agkaminski/ZAK180/3dprint/bottom.stl

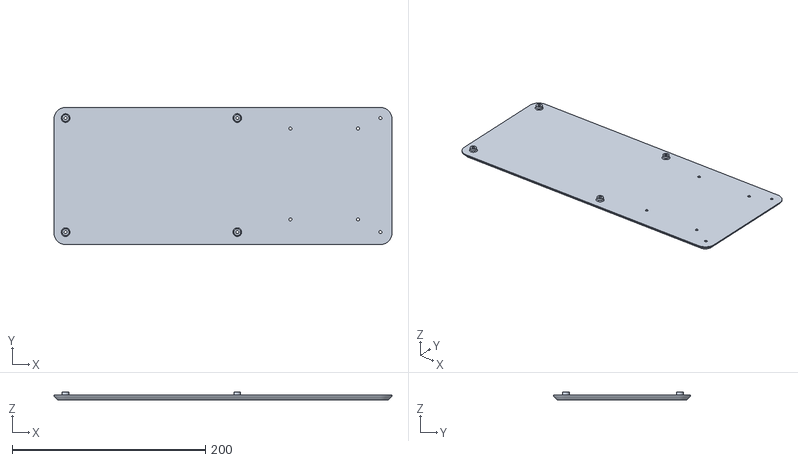
[picture p1: CAD file, 2025-01-13]
3dprint/bottom.stl
350.0 x 142.0 x 8.40
