agkaminski/ZAK180/extras/ESP8266/case.stl

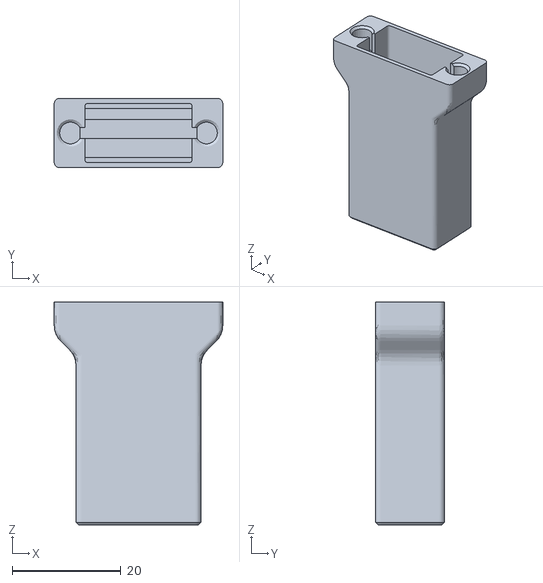
[picture p2: CAD file, 2024-10-10]
extras/ESP8266/case.stl
31.0 x 12.8 x 41.0
