agkaminski/ZAK180/3dprint/case.FCStd

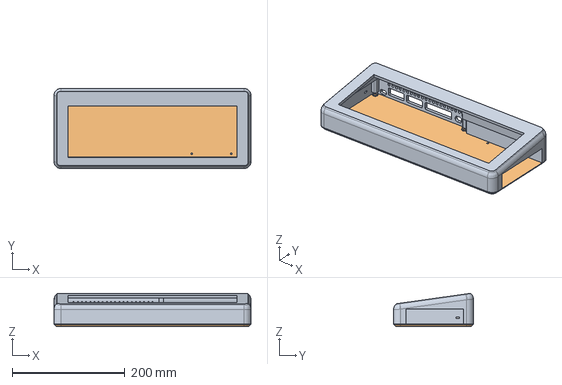
[picture p3: CAD file, 2025-01-13]
3dprint/case.FCStd
350.0 x 142.0 x 59.3 mm
case
bottom
