agkaminski/ZAK180/3dprint/dev.FCStd

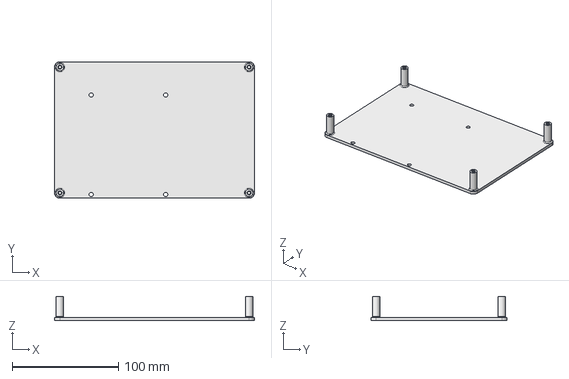
[picture p4: CAD file, 2024-09-09]
3dprint/dev.FCStd
188.0 x 128.3 x 23.0 mm
