agkaminski/ZAK180/(list of files, cad)

Other CAD files:
3dprint/case.stl
3dprint/dev.stl
