agkaminski/ZAK180/schematic.pdf

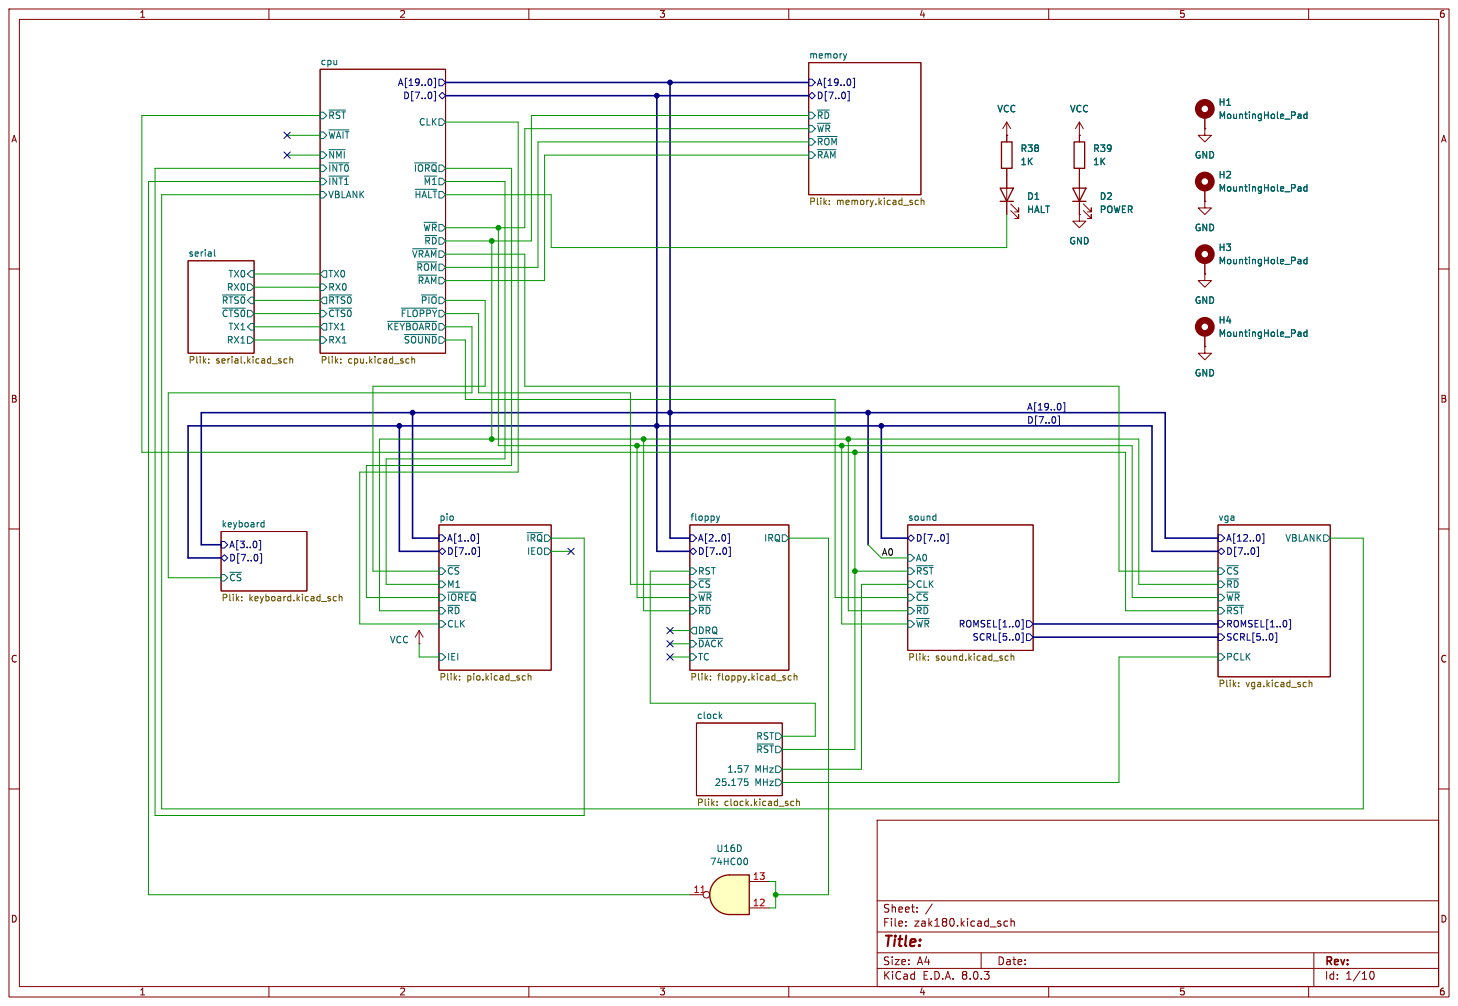
[picture p5: page 1]

Id: 1/10 Title: File: zak180.kicad_sch Sheet: /

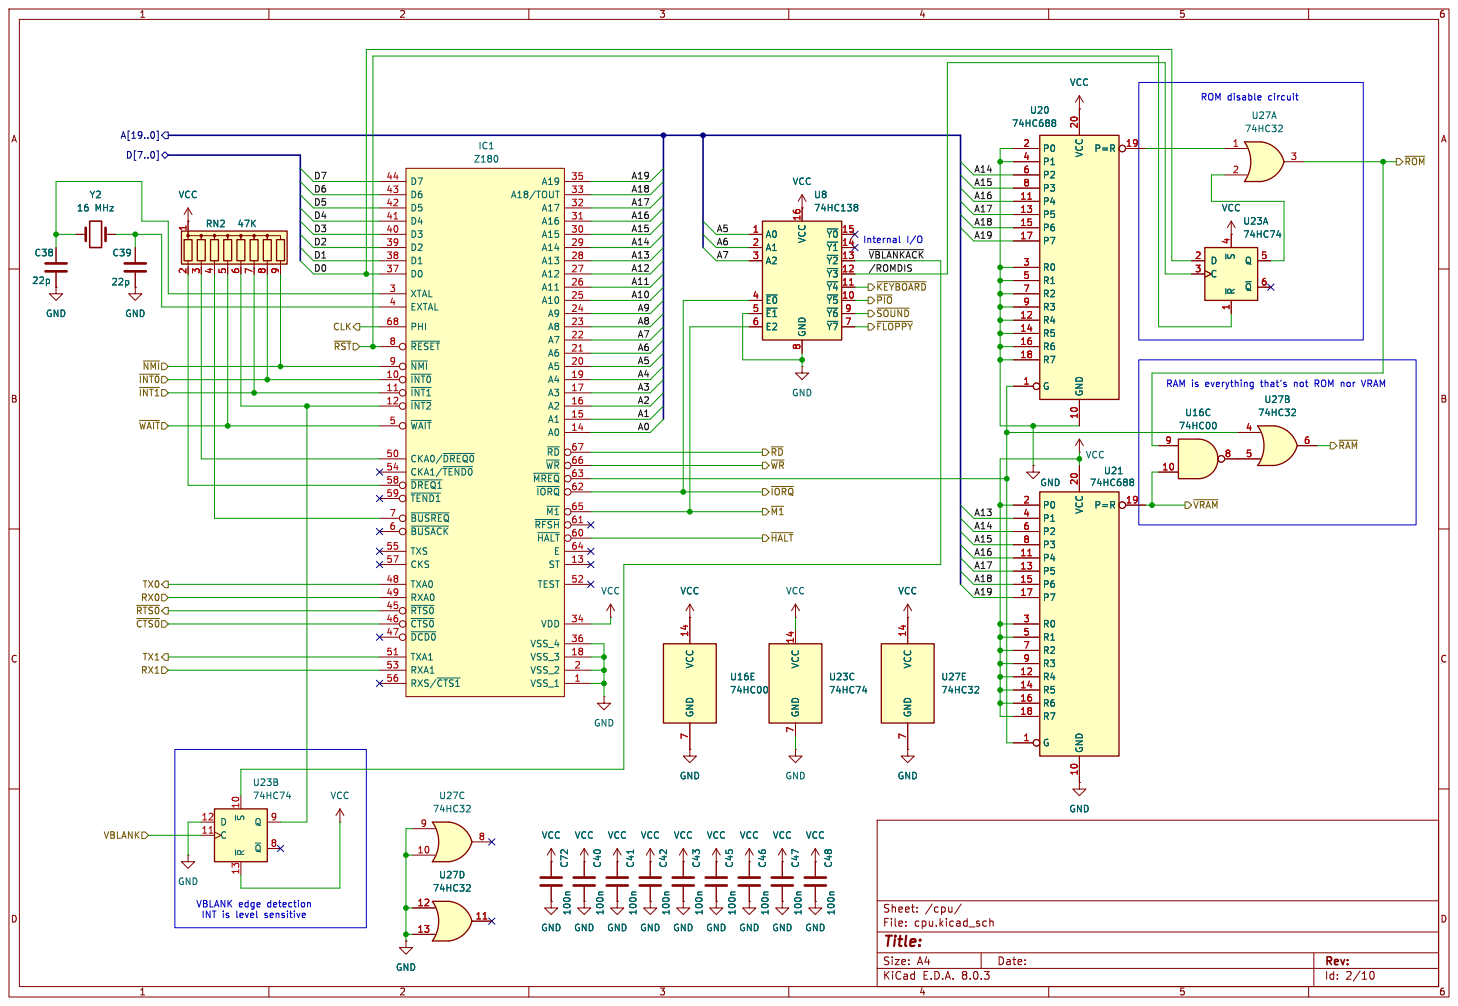
[picture p6: page 2]

ROM disable circuit VCC

VBLANK edge detection
INT is level sensitive

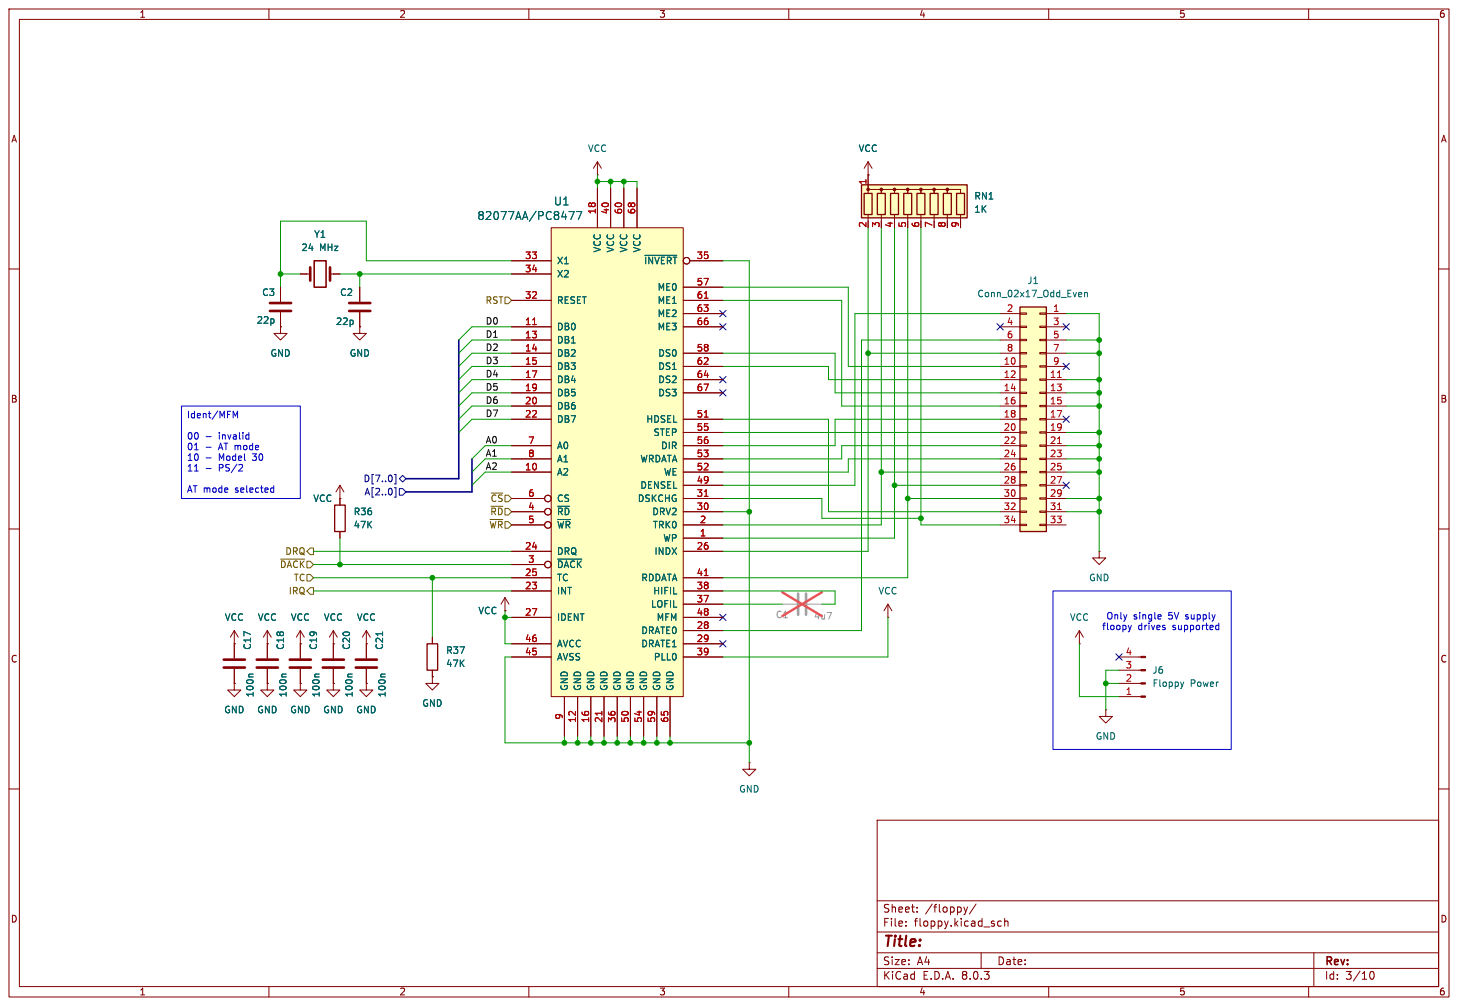
[picture p7: page 3]

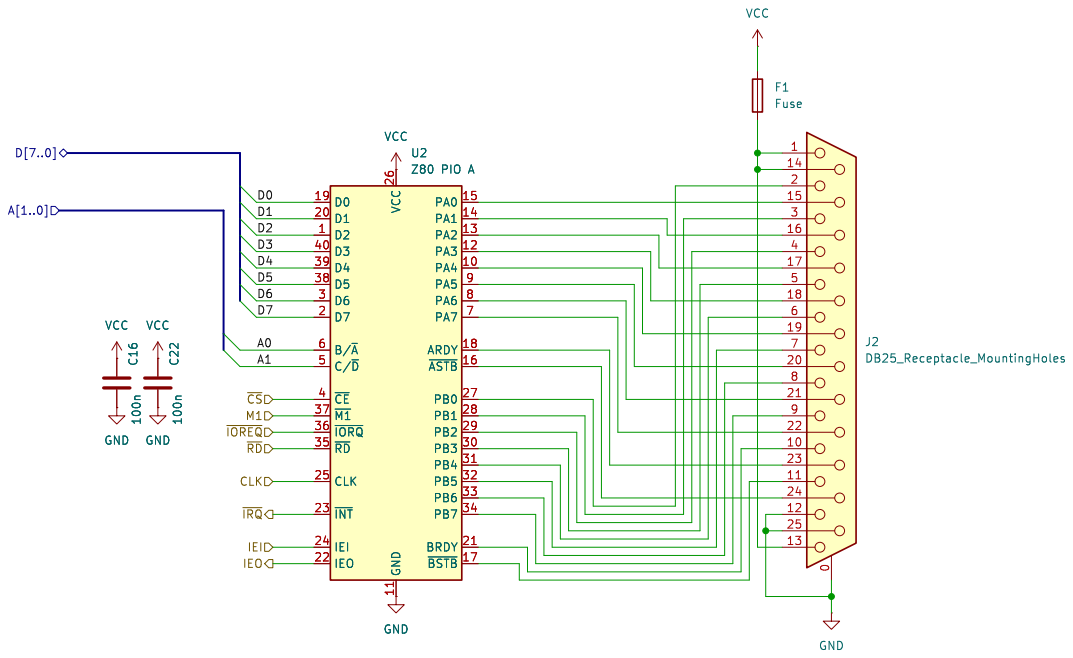
[picture p8: page 4]

Id: 5/10 Title: File: pio.kicad_sch Sheet: /pio/

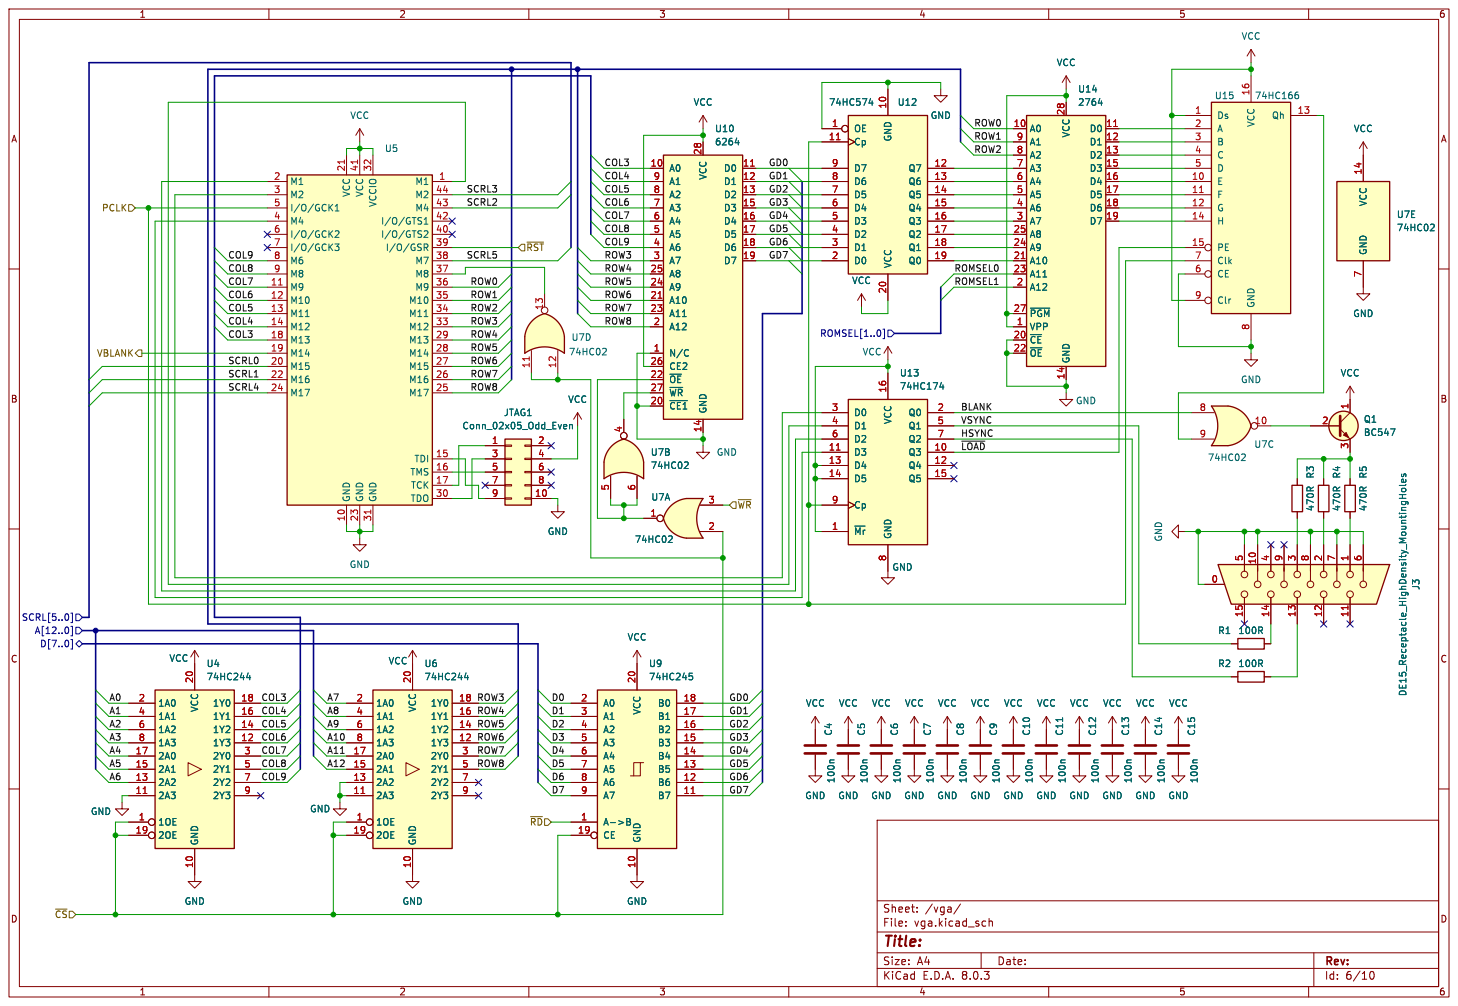
[picture p9: page 5]

3 Q1 BC547 VCC VCC GND GND GND C12 100n VCC

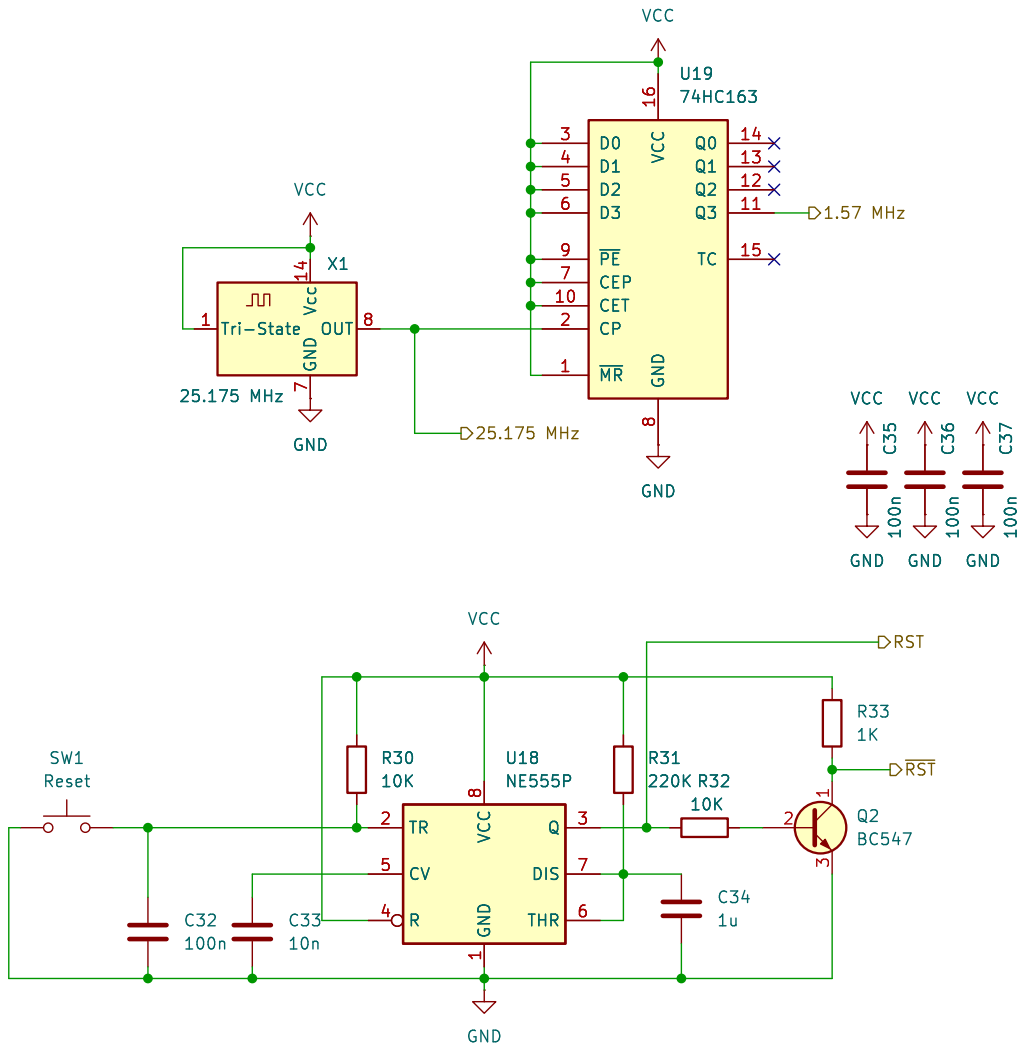
[picture p10: page 6]

Id: 7/10 Title: File: clock.kicad_sch Sheet: /clock/ C34

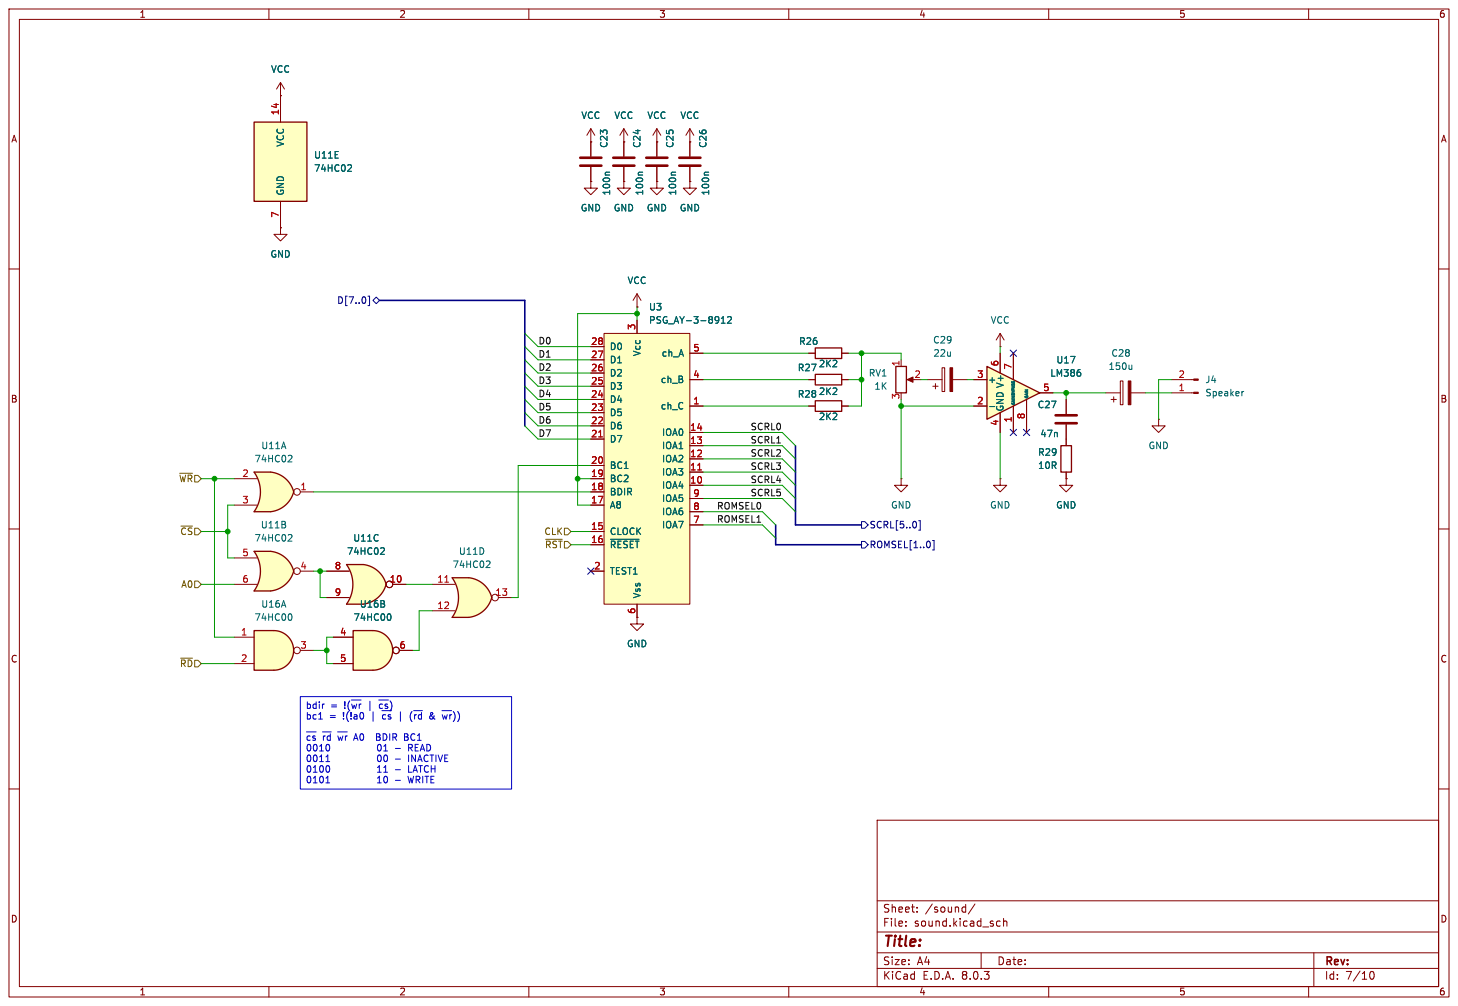
[picture p11: page 7]

bdir = !(~{wr}| ~{cs}) bc1 = !(!a0 | ~{cs}| (~{rd}& ~{wr}))

~{cs}~{rd}~{wr}A0 BDIR BC1

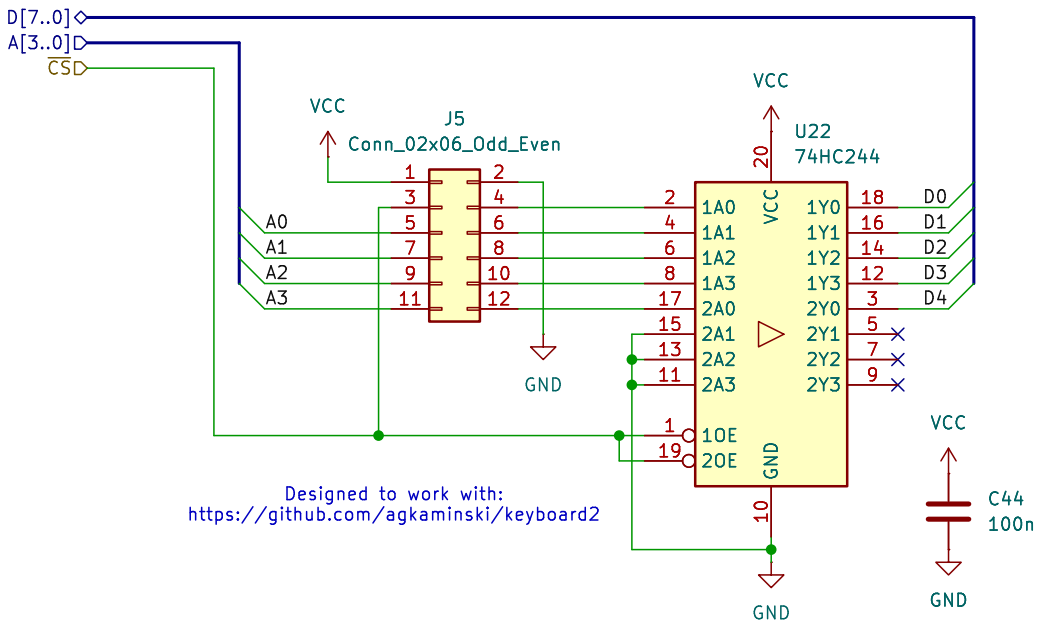
[picture p12: page 8]

Id: 8/10 Title: File: keyboard.kicad_sch Sheet: /keyboard/ VCC

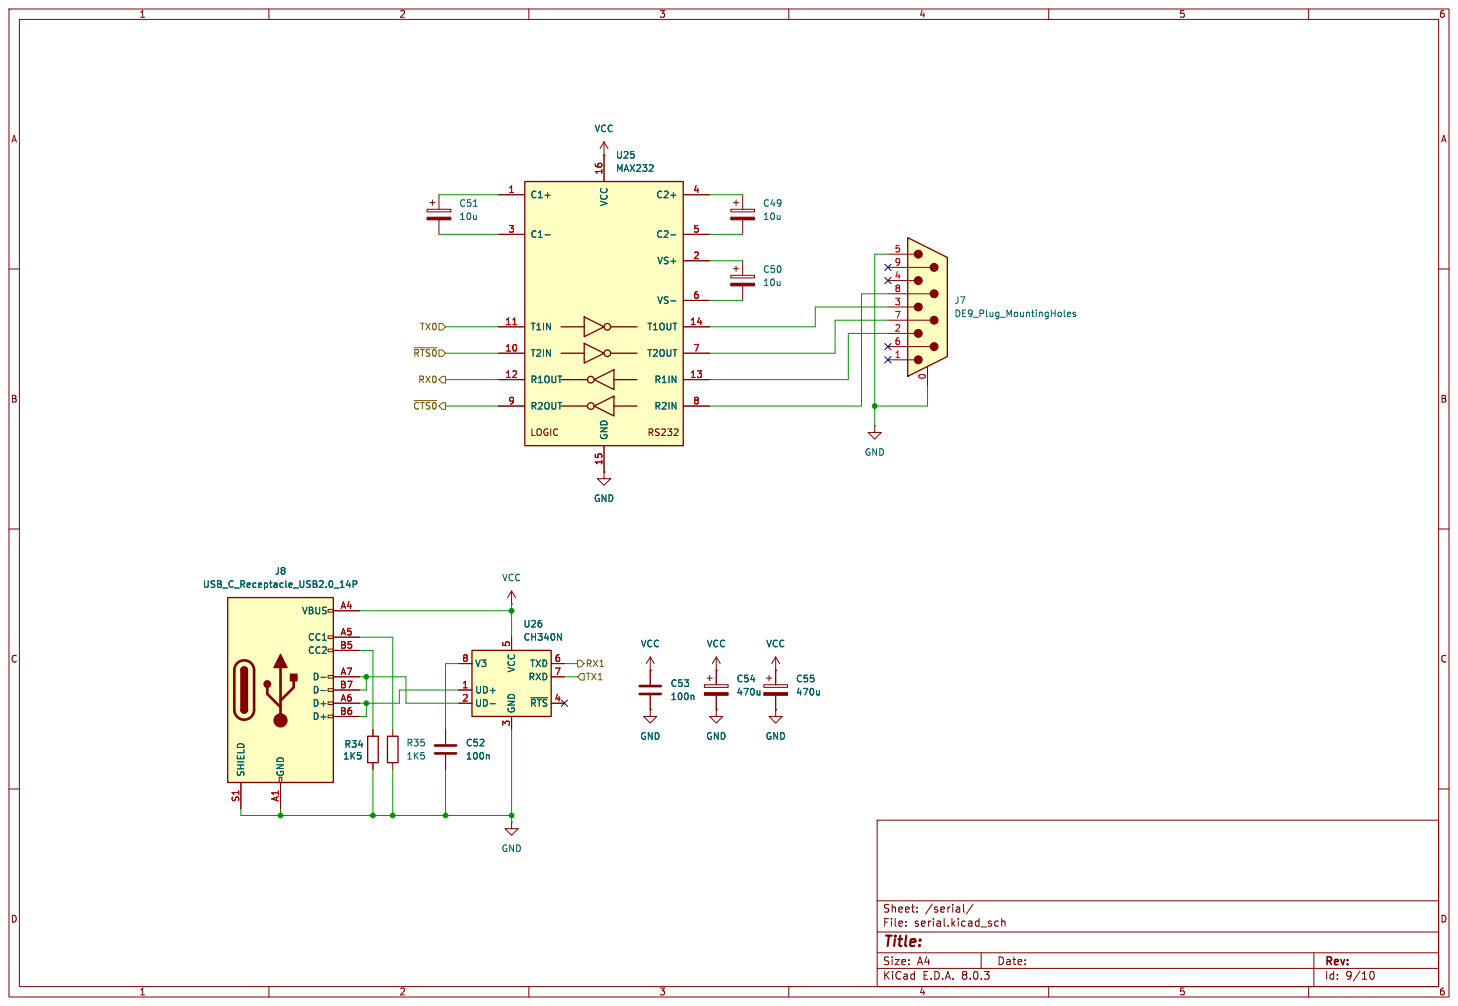
[picture p13: page 9]

Id: 9/10 Title: File: serial.kicad_sch Sheet: /serial/ C52

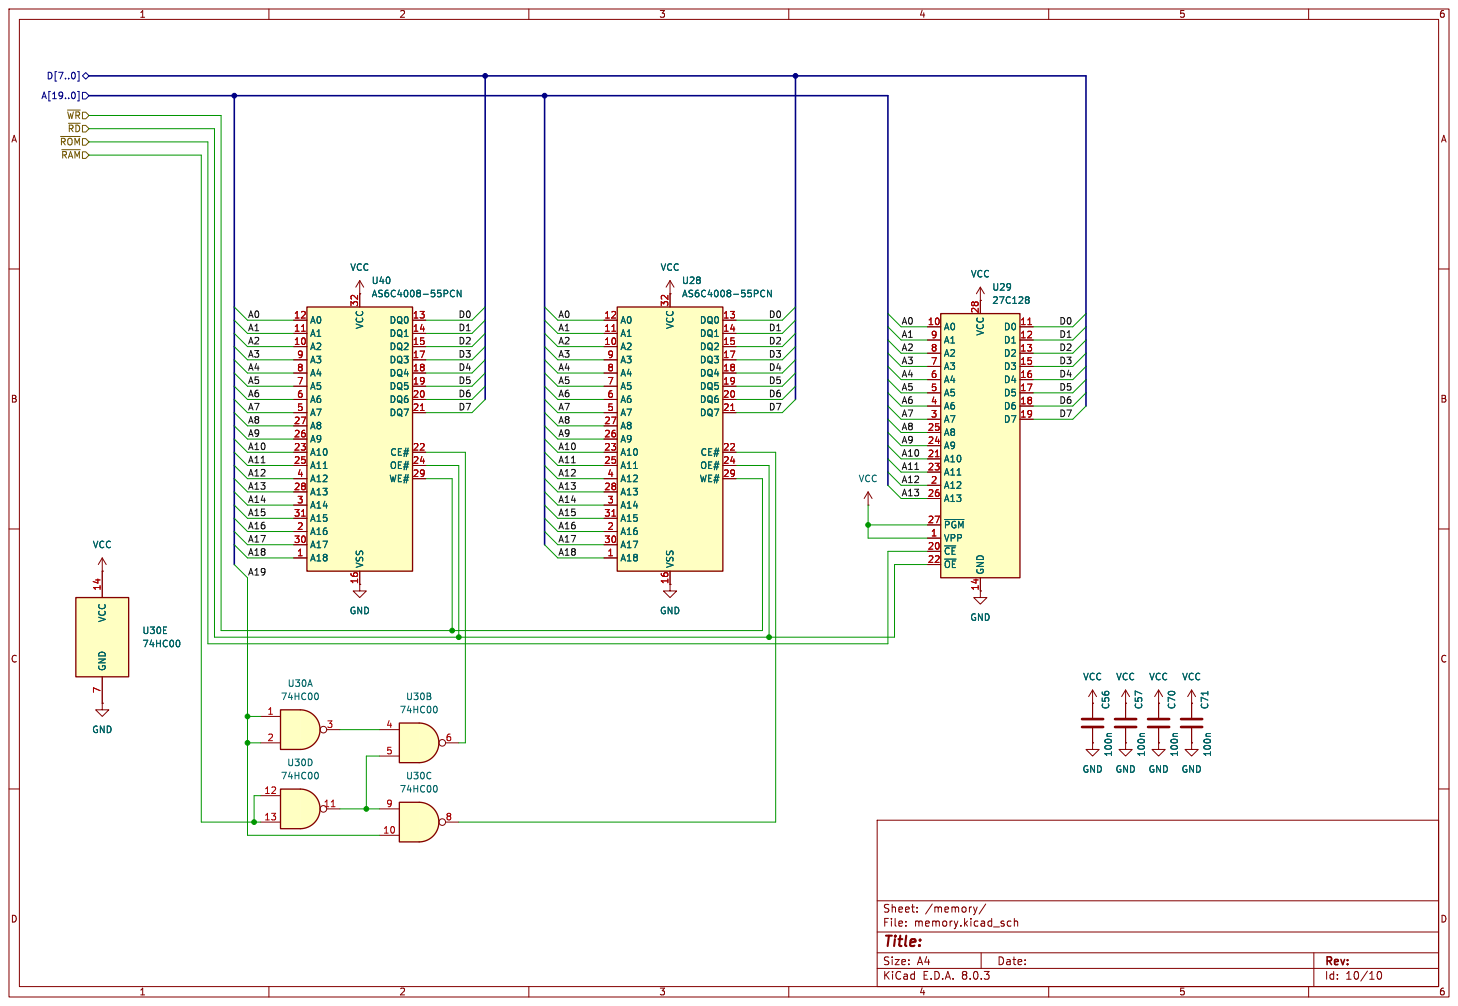
[picture p14: page 10]
