agkaminski/ZAK180/extras/ESP8266/ESP8266.kicad_pcb

## KiCad design extras/ESP8266/ESP8266.kicad_pcb (2024-10-10)

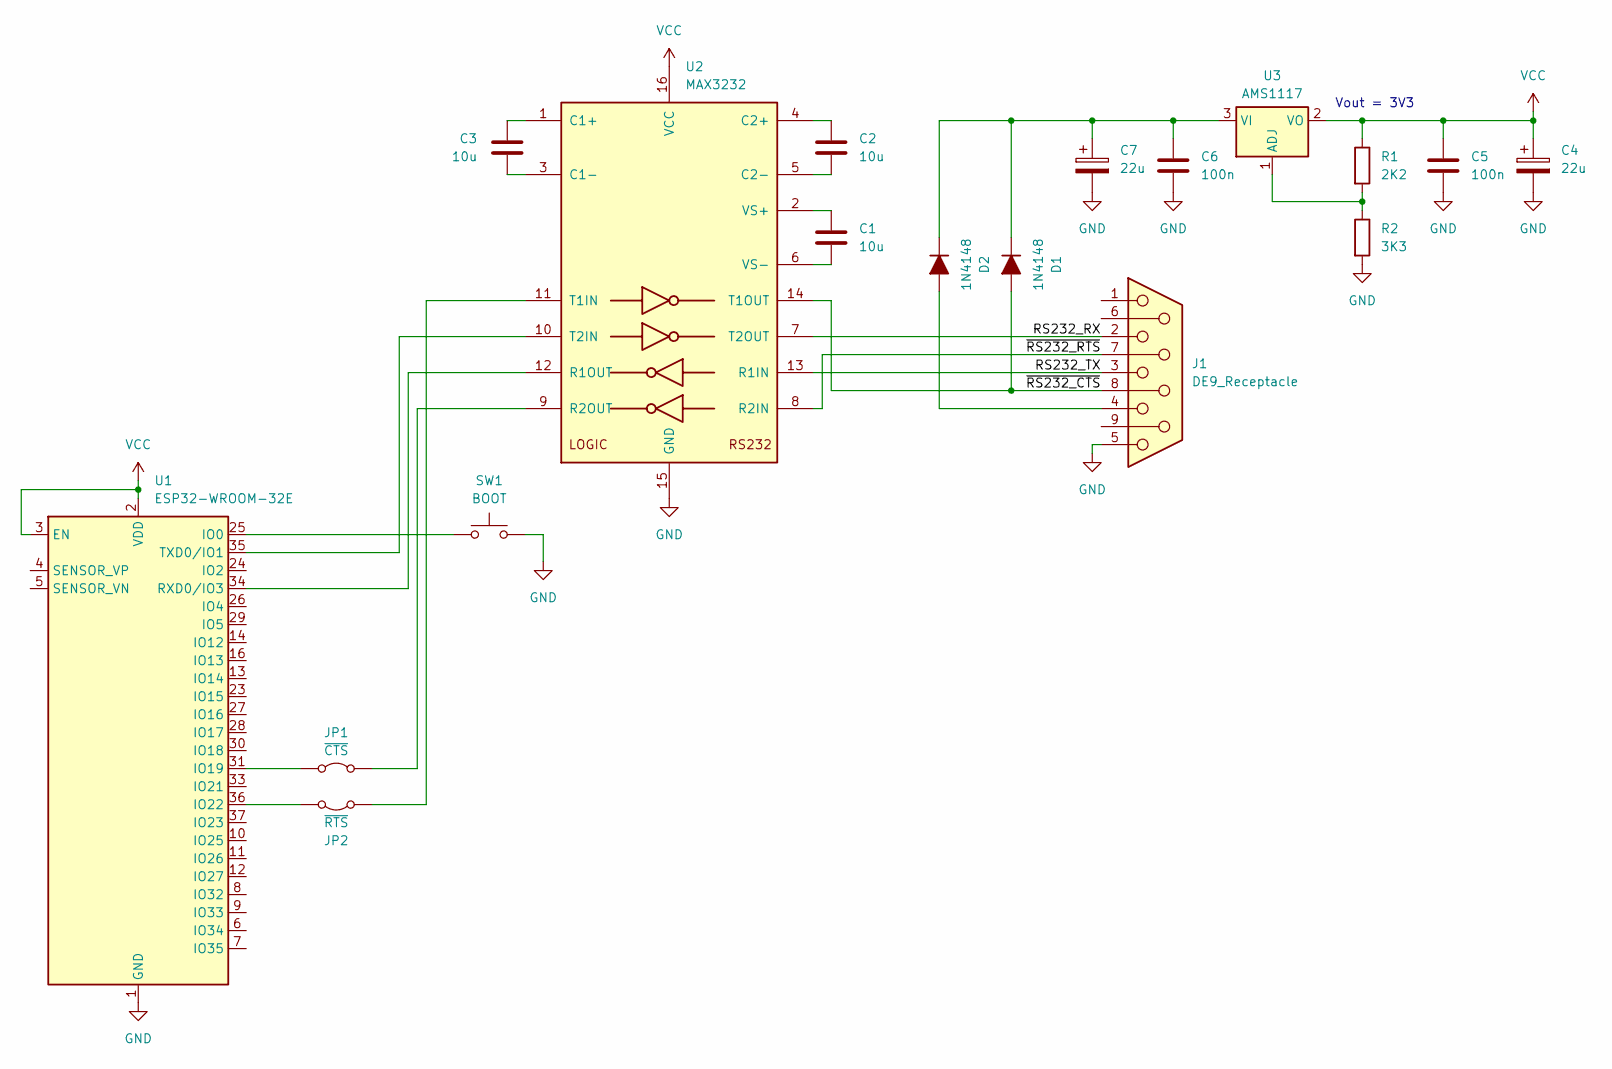
[picture p15: schematic ESP8266.kicad_sch]

Parts:
C1, C2, C3: 10u; C_0805_2012Metric_Pad1.18x1.45mm_HandSolder
C4, C7: 22u; CP_EIA-3528-15_AVX-H_Pad1.50x2.35mm_HandSolder
C5, C6: 100n; C_0805_2012Metric_Pad1.18x1.45mm_HandSolder
D1, D2: 1N4148; D_MiniMELF
J1: DE9_Receptacle; DSUB-9_Female_EdgeMount_P2.77mm
JP1: ~{CTS}; SolderJumper-2_P1.3mm_Bridged_RoundedPad1.0x1.5mm
JP2: ~{RTS}; SolderJumper-2_P1.3mm_Bridged_RoundedPad1.0x1.5mm
R1: 2K2; R_0805_2012Metric_Pad1.15x1.40mm_HandSolder
R2: 3K3; R_0805_2012Metric_Pad1.15x1.40mm_HandSolder
SW1: BOOT; SW_SPST_PTS645
U1: ESP32-WROOM-32E; ESP32-WROOM-32D
U2: MAX3232; SOP-16_4.4x10.4mm_P1.27mm
U3: AMS1117; SOT-223-3_TabPin2

Connections:
/RS232_RX: J1.2, U2.7 (T2OUT)
/RS232_TX: J1.3, U2.13 (R1IN)
/~RS232_CTS: D1.2 (A), J1.8, U2.14 (T1OUT)
/~RS232_RTS: J1.7, U2.8 (R2IN)
GND: C4.2, C5.2, C6.2, C7.2, J1.5, R2.2, SW1.2, U1.1 (GND), U1.15 (GND), U1.38 (GND), U1.39 (GND), U2.15 (GND)
unnamed: C6.1, C7.1, D1.1 (K), D2.1 (K), U3.3 (VI)
unnamed: D2.2 (A), J1.4
unnamed: JP1.1 (A), U1.31 (IO19)
unnamed: JP1.2 (B), U2.9 (R2OUT)
unnamed: JP2.1 (A), U1.36 (IO22)
unnamed: JP2.2 (B), U2.11 (T1IN)
unnamed: SW1.1, U1.25 (IO0)
unnamed: U1.34 (RXD0/IO3), U2.12 (R1OUT)
unnamed: U1.35 (TXD0/IO1), U2.10 (T2IN)
unnamed: C3.2, U2.1 (C1+)
unnamed: C3.1, U2.3 (C1-)
unnamed: C2.1, U2.4 (C2+)
unnamed: C2.2, U2.5 (C2-)
unnamed: C1.1, U2.2 (VS+)
unnamed: C1.2, U2.6 (VS-)
unnamed: R1.2, R2.1, U3.1 (ADJ)
VCC: C4.1, C5.1, R1.1, U1.2 (VDD), U1.3 (EN), U2.16 (VCC), U3.2 (VO)

Notes on the sheet:
Vout = 3V3

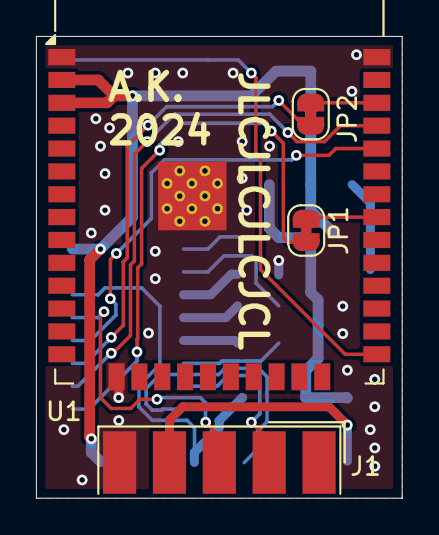
[picture p16: board ESP8266.kicad_pcb from above]

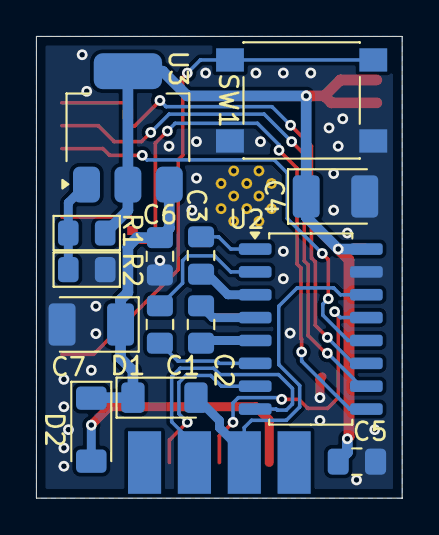
[picture p17: board ESP8266.kicad_pcb from below]

Board: 2 copper layers, 20.3 x 25.7 mm, 18 parts (14 on the bottom side), 22 nets.
