agkaminski/ZAK180/kicad/clock.kicad_sch

## KiCad design kicad/clock.kicad_sch (2024-09-22)

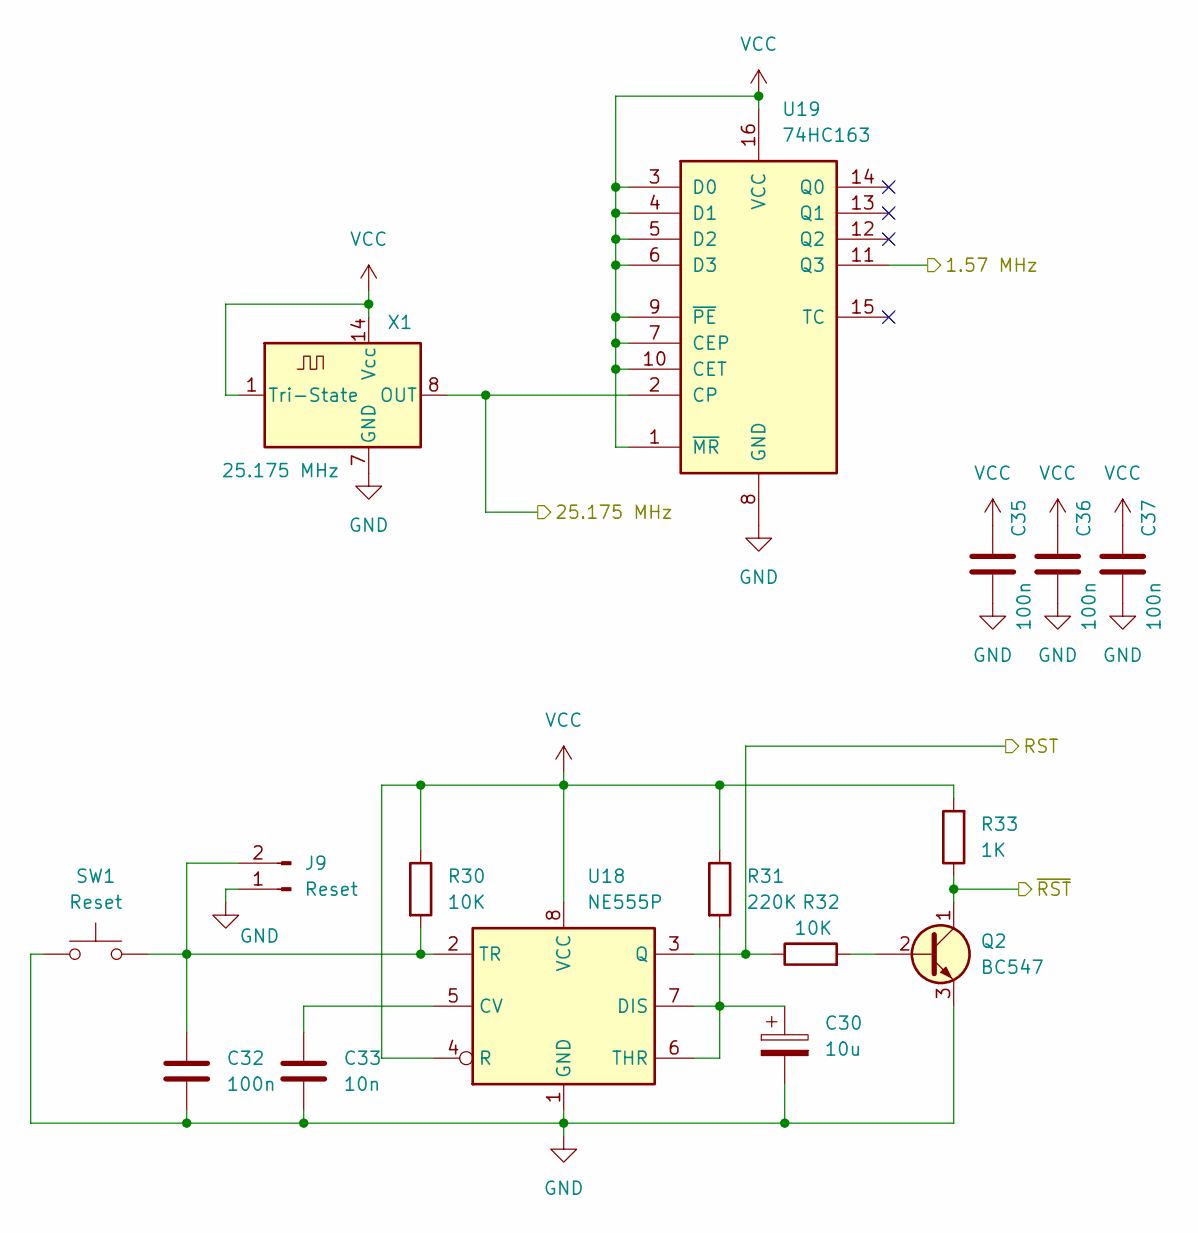
[picture p18: schematic clock.kicad_sch]

Parts:
C30: 10u; CP_Radial_D5.0mm_P2.50mm
C32, C35, C36, C37: 100n; C_Disc_D5.0mm_W2.5mm_P2.50mm
C33: 10n; C_Disc_D5.0mm_W2.5mm_P2.50mm
J9: Reset; PinHeader_1x02_P2.54mm_Vertical
Q2: BC547; TO-92
R30, R32: 10K; R_Axial_DIN0207_L6.3mm_D2.5mm_P7.62mm_Horizontal
R31: 220K; R_Axial_DIN0207_L6.3mm_D2.5mm_P7.62mm_Horizontal
R33: 1K; R_Axial_DIN0207_L6.3mm_D2.5mm_P7.62mm_Horizontal
SW1: Reset; SW_TH_Tactile_Omron_B3F-10xx
U18: NE555P; DIP-8_W7.62mm
U19: 74HC163; DIP-16_W7.62mm
X1: 25.175 MHz; Oscillator_DIP-14

Connections:
1.57 MHz: U19.11 (Q3)
25.175 MHz: U19.2 (CP), X1.8 (OUT)
GND: C30.2, C32.2, C33.2, C35.2, C36.2, C37.2, J9.1, Q2.3 (E), SW1.1, U18.1 (GND), U19.8 (GND), X1.7 (GND)
unnamed: C30.1, R31.2, U18.6 (THR), U18.7 (DIS)
unnamed: C32.1, J9.2, R30.2, SW1.2, U18.2 (TR)
unnamed: C33.1, U18.5 (CV)
unnamed: Q2.2 (B), R32.2
RST: R32.1, U18.3 (Q)
VCC: C35.1, C36.1, C37.1, R30.1, R31.1, R33.2, U18.4 (R), U18.8 (VCC), U19.1 (~MR), U19.3 (D0), U19.4 (D1), U19.5 (D2), U19.6 (D3), U19.7 (CEP), U19.9 (~PE), U19.10 (CET), U19.16 (VCC), X1.1 (Tri-State), X1.14 (Vcc)
~RST: Q2.1 (C), R33.1
