agkaminski/ZAK180/kicad/cpu.kicad_sch

## KiCad design kicad/cpu.kicad_sch (2024-09-22)

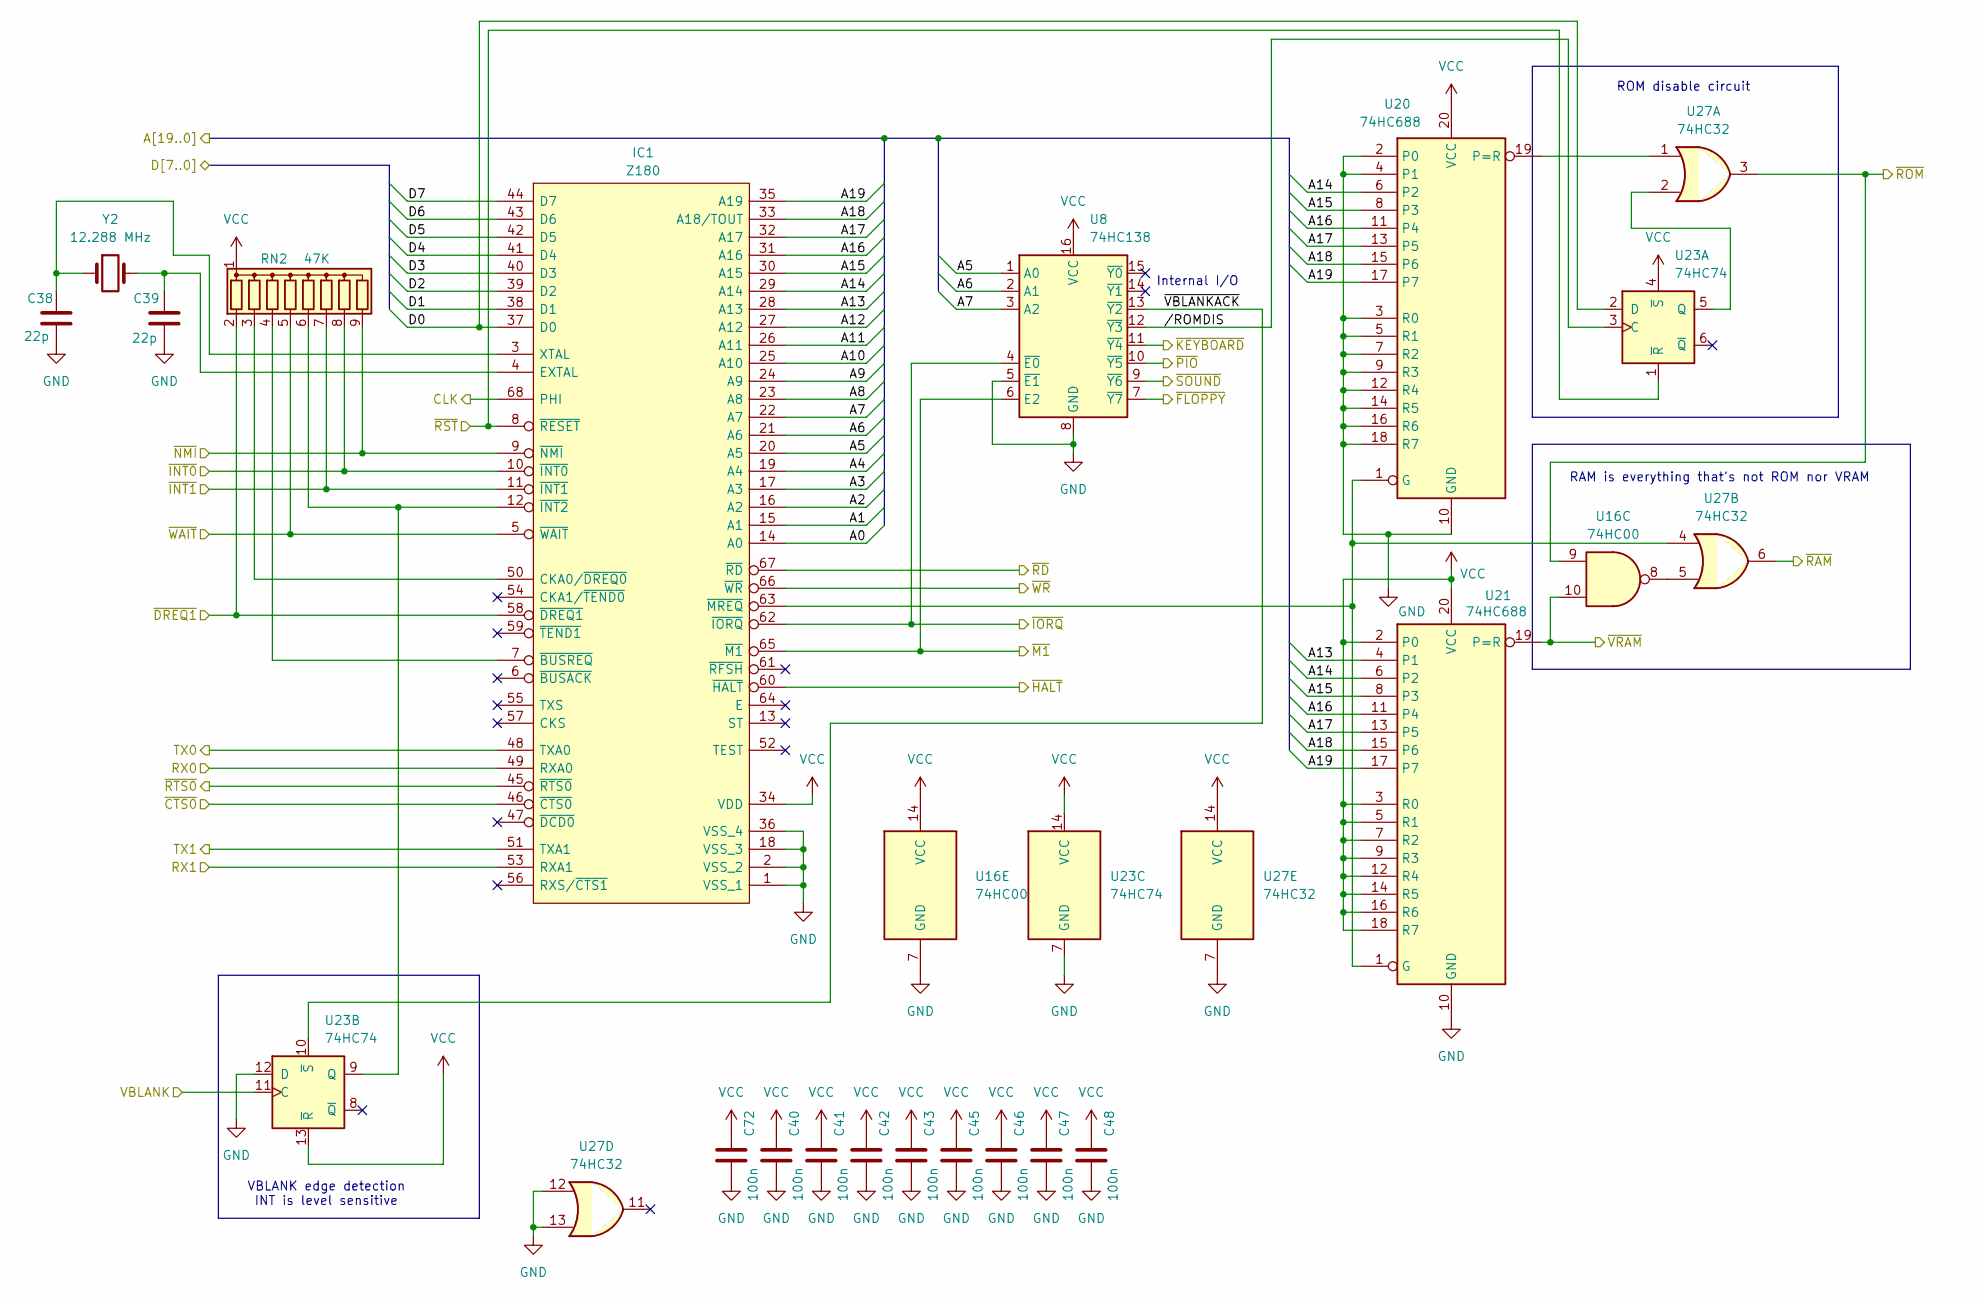
[picture p19: schematic cpu.kicad_sch]

Parts:
C38, C39: 22p; C_Disc_D5.0mm_W2.5mm_P2.50mm
C40, C41, C42, C43, C45, C46, C47, C48, C72: 100n; C_Disc_D5.0mm_W2.5mm_P2.50mm
IC1: Z180; PLCC-68_THT-Socket; Manufacturer_Part_Number Z8S18033VSG; Mouser Part Number 692-Z8S18033VSG
RN2: 47K; R_Array_SIP9
U8: 74HC138; DIP-16_W7.62mm
U16: 74HC00; DIP-14_W7.62mm
U20, U21: 74HC688; DIP-20_W7.62mm
U23: 74HC74; DIP-14_W7.62mm
U27: 74HC32; DIP-14_W7.62mm
Y2: 12.288 MHz; Crystal_HC49-4H_Vertical

Connections:
A0: IC1.14 (A0)
A1: IC1.15 (A1)
A2: IC1.16 (A2)
A3: IC1.17 (A3)
A4: IC1.19 (A4)
A5: IC1.20 (A5), U8.1 (A0)
A6: IC1.21 (A6), U8.2 (A1)
A7: IC1.22 (A7), U8.3 (A2)
A8: IC1.23 (A8)
A9: IC1.24 (A9)
A10: IC1.25 (A10)
A11: IC1.26 (A11)
A12: IC1.27 (A12)
A13: IC1.28 (A13), U21.4 (P1)
A14: IC1.29 (A14), U20.6 (P2), U21.6 (P2)
A15: IC1.30 (A15), U20.8 (P3), U21.8 (P3)
A16: IC1.31 (A16), U20.11 (P4), U21.11 (P4)
A17: IC1.32 (A17), U20.13 (P5), U21.13 (P5)
A18: IC1.33 (A18/TOUT), U20.15 (P6), U21.15 (P6)
A19: IC1.35 (A19), U20.17 (P7), U21.17 (P7)
CLK: IC1.68 (PHI)
D0: IC1.37 (D0), U23.2 (D)
D1: IC1.38 (D1)
D2: IC1.39 (D2)
D3: IC1.40 (D3)
D4: IC1.41 (D4)
D5: IC1.42 (D5)
D6: IC1.43 (D6)
D7: IC1.44 (D7)
GND: C38.1, C39.1, C40.2, C41.2, C42.2, C43.2, C45.2, C46.2, C47.2, C48.2, C72.2, IC1.1 (VSS_1), IC1.2 (VSS_2), IC1.18 (VSS_3), IC1.36 (VSS_4), U8.5 (~E1), U8.8 (GND), U16.7 (GND), U20.2 (P0), U20.3 (R0), U20.4 (P1), U20.5 (R1), U20.7 (R2), U20.9 (R3), U20.10 (GND), U20.12 (R4), U20.14 (R5), U20.16 (R6), U20.18 (R7), U21.10 (GND), U23.7 (GND), U23.12 (D), U27.7 (GND), U27.12, U27.13
unnamed: C38.2, IC1.3 (XTAL), Y2.1
unnamed: C39.2, IC1.4 (EXTAL), Y2.2
unnamed: IC1.7 (~BUSREQ), RN2.4 (R3)
unnamed: IC1.12 (~INT2), RN2.6 (R5), U23.9 (Q)
unnamed: IC1.50 (CKA0/~DREQ0), RN2.3 (R2)
unnamed: IC1.63 (~MREQ), U20.1 (G), U21.1 (G), U27.4
unnamed: U16.8, U27.5
unnamed: U20.19 (P=R), U27.1
unnamed: U23.5 (Q), U27.2
RX0: IC1.49 (RXA0)
RX1: IC1.53 (RXA1)
TX0: IC1.48 (TXA0)
TX1: IC1.51 (TXA1)
VBLANK: U23.11 (C)
VCC: C40.1, C41.1, C42.1, C43.1, C45.1, C46.1, C47.1, C48.1, C72.1, IC1.34 (VDD), RN2.1 (common), U8.16 (VCC), U16.14 (VCC), U20.20 (VCC), U21.2 (P0), U21.3 (R0), U21.5 (R1), U21.7 (R2), U21.9 (R3), U21.12 (R4), U21.14 (R5), U21.16 (R6), U21.18 (R7), U21.20 (VCC), U23.4 (~S), U23.13 (~R), U23.14 (VCC), U27.14 (VCC)
/ROMDIS: U8.12 (~Y3), U23.3 (C)
~CTS0: IC1.46 (~CTS0)
~DREQ1: IC1.58 (~DREQ1), RN2.2 (R1)
~FLOPPY: U8.7 (~Y7)
~HALT: IC1.60 (~HALT)
~INT0: IC1.10 (~INT0), RN2.8 (R7)
~INT1: IC1.11 (~INT1), RN2.7 (R6)
~IORQ: IC1.62 (~IORQ), U8.4 (~E0)
~KEYBOARD: U8.11 (~Y4)
~M1: IC1.65 (~M1), U8.6 (E2)
~NMI: IC1.9 (~NMI), RN2.9 (R8)
~PIO: U8.10 (~Y5)
~RAM: U27.6
~RD: IC1.67 (~RD)
~ROM: U16.9, U27.3
~RST: IC1.8 (~RESET), U23.1 (~R)
~RTS0: IC1.45 (~RTS0)
~SOUND: U8.9 (~Y6)
~VBLANKACK: U8.13 (~Y2), U23.10 (~S)
~VRAM: U16.10, U21.19 (P=R)
~WAIT: IC1.5 (~WAIT), RN2.5 (R4)
~WR: IC1.66 (~WR)

Notes on the sheet:
RAM is everything that's not ROM nor VRAM
Internal I/O
ROM disable circuit
VBLANK edge detection INT is level sensitive
