agkaminski/ZAK180/kicad/floppy.kicad_sch

## KiCad design kicad/floppy.kicad_sch (2024-09-22)

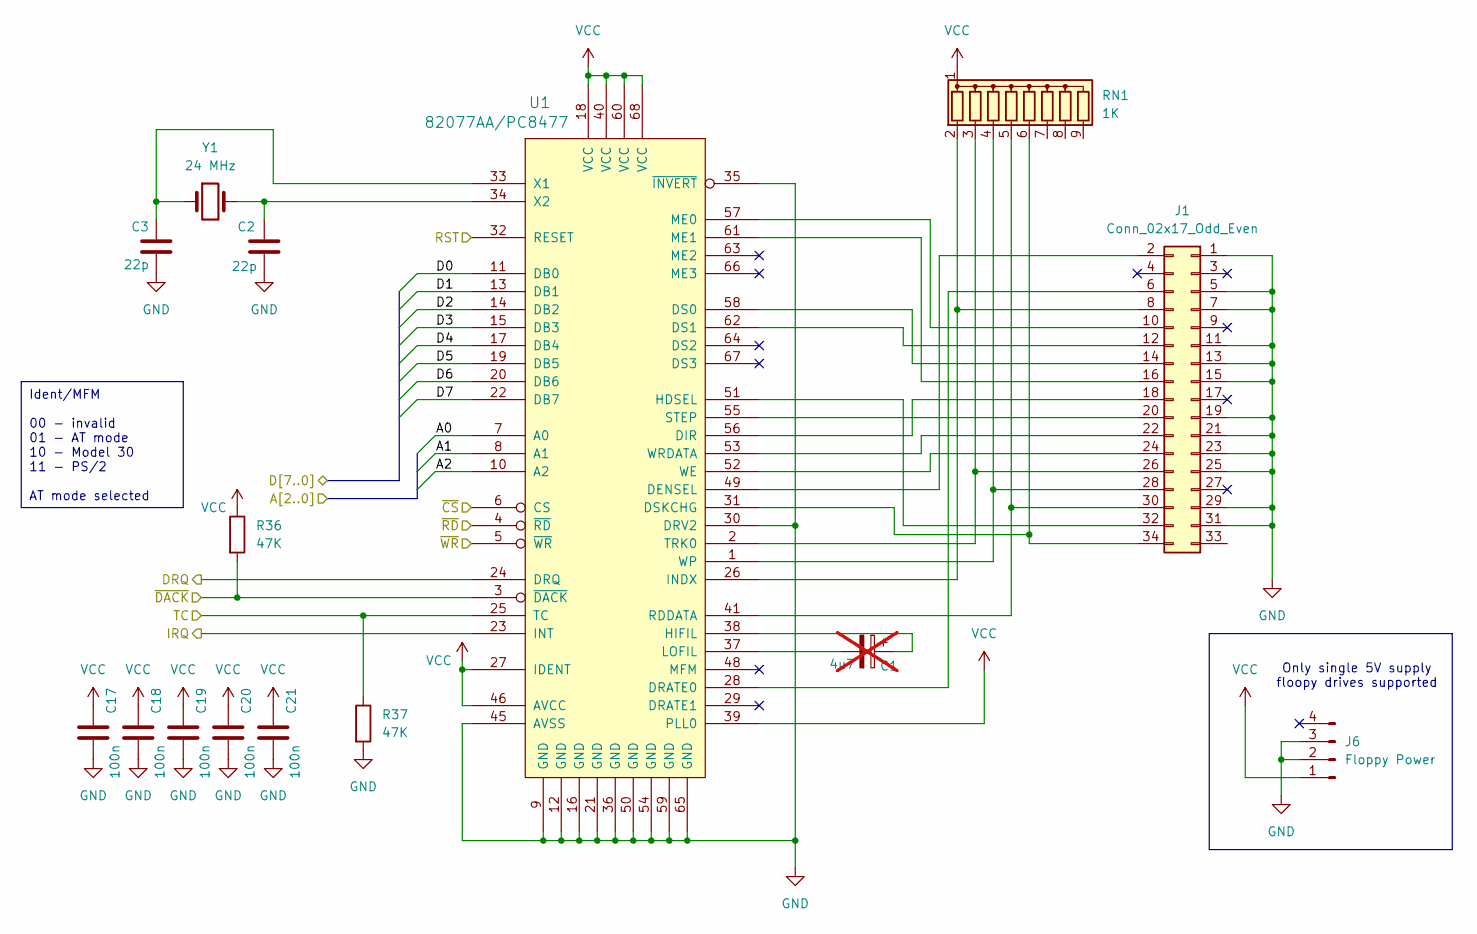
[picture p20: schematic floppy.kicad_sch]

Parts:
C1: 4u7; CP_Radial_D5.0mm_P2.50mm; not fitted
C2, C3: 22p; C_Disc_D5.0mm_W2.5mm_P2.50mm
C17, C18, C19, C20, C21: 100n; C_Disc_D5.0mm_W2.5mm_P2.50mm
J1: Conn_02x17_Odd_Even; IDC-Header_2x17_P2.54mm_Vertical
J6: Floppy Power; PinHeader_1x04_P2.54mm_Horizontal
R36, R37: 47K; R_Axial_DIN0207_L6.3mm_D2.5mm_P7.62mm_Horizontal
RN1: 1K; R_Array_SIP9
U1: 82077AA/PC8477; PLCC-68_THT-Socket
Y1: 24 MHz; Crystal_HC49-4H_Vertical

Connections:
A0: U1.7 (A0)
A1: U1.8 (A1)
A2: U1.10 (A2)
D0: U1.11 (DB0)
D1: U1.13 (DB1)
D2: U1.14 (DB2)
D3: U1.15 (DB3)
D4: U1.17 (DB4)
D5: U1.19 (DB5)
D6: U1.20 (DB6)
D7: U1.22 (DB7)
DRQ: U1.24 (DRQ)
GND: C2.1, C3.1, C17.2, C18.2, C19.2, C20.2, C21.2, J1.1, J1.5, J1.7, J1.11, J1.13, J1.15, J1.19, J1.21, J1.23, J1.25, J1.29, J1.31, J6.2, J6.3, R37.2, U1.9 (GND), U1.12 (GND), U1.16 (GND), U1.21 (GND), U1.30 (DRV2), U1.35 (~INVERT), U1.36 (GND), U1.45 (AVSS), U1.50 (GND), U1.54 (GND), U1.59 (GND), U1.65 (GND)
IRQ: U1.23 (INT)
unnamed: C1.1, U1.38 (HIFIL)
unnamed: C1.2, U1.37 (LOFIL)
unnamed: C2.2, U1.34 (X2), Y1.2
unnamed: C3.2, U1.33 (X1), Y1.1
unnamed: J1.2, U1.49 (DENSEL)
unnamed: J1.6, U1.28 (DRATE0)
unnamed: J1.8, RN1.2 (R1), U1.26 (INDX)
unnamed: J1.10, U1.57 (ME0)
unnamed: J1.12, U1.62 (DS1)
unnamed: J1.14, U1.58 (DS0)
unnamed: J1.16, U1.61 (ME1)
unnamed: J1.18, U1.56 (DIR)
unnamed: J1.20, U1.55 (STEP)
unnamed: J1.22, U1.53 (WRDATA)
unnamed: J1.24, U1.52 (WE)
unnamed: J1.26, RN1.3 (R2), U1.2 (TRK0)
unnamed: J1.28, RN1.4 (R3), U1.1 (WP)
unnamed: J1.30, RN1.5 (R4), U1.41 (RDDATA)
unnamed: J1.32, U1.51 (HDSEL)
unnamed: J1.34, RN1.6 (R5), U1.31 (DSKCHG)
RST: U1.32 (RESET)
TC: R37.1, U1.25 (TC)
VCC: C17.1, C18.1, C19.1, C20.1, C21.1, J6.1, R36.1, RN1.1 (common), U1.18 (VCC), U1.27 (IDENT), U1.39 (PLL0), U1.40 (VCC), U1.46 (AVCC), U1.60 (VCC), U1.68 (VCC)
~CS: U1.6 (CS)
~DACK: R36.2, U1.3 (~DACK)
~RD: U1.4 (~RD)
~WR: U1.5 (~WR)

Notes on the sheet:
Ident/MFM 00 - invalid 01 - AT mode 10 - Model 30 11 - PS/2 AT mode selected
Only single 5V supply floopy drives supported
