agkaminski/ZAK180/kicad/keyboard.kicad_sch

## KiCad design kicad/keyboard.kicad_sch (2024-08-29)

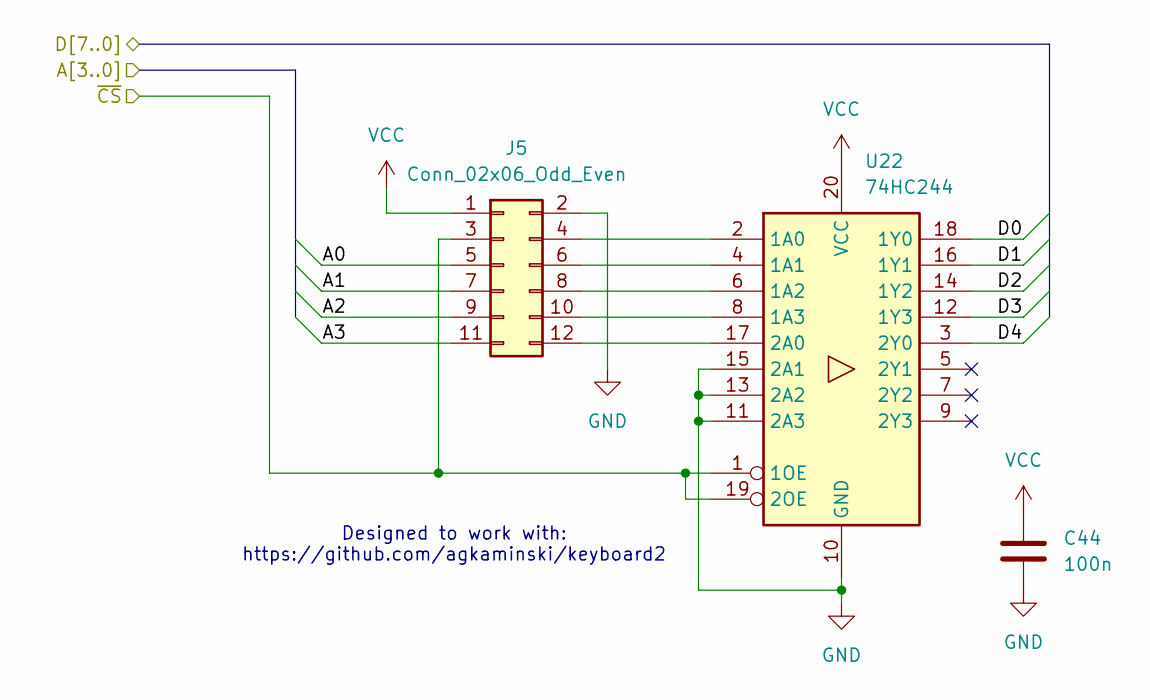
[picture p21: schematic keyboard.kicad_sch]

Parts:
C44: 100n; C_Disc_D5.0mm_W2.5mm_P2.50mm
J5: Conn_02x06_Odd_Even; IDC-Header_2x06_P2.54mm_Vertical
U22: 74HC244; DIP-20_W7.62mm

Connections:
A0: J5.5
A1: J5.7
A2: J5.9
A3: J5.11
D0: U22.18 (1Y0)
D1: U22.16 (1Y1)
D2: U22.14 (1Y2)
D3: U22.12 (1Y3)
D4: U22.3 (2Y0)
GND: C44.2, J5.2, U22.10 (GND), U22.11 (2A3), U22.13 (2A2), U22.15 (2A1)
unnamed: J5.4, U22.2 (1A0)
unnamed: J5.6, U22.4 (1A1)
unnamed: J5.8, U22.6 (1A2)
unnamed: J5.10, U22.8 (1A3)
unnamed: J5.12, U22.17 (2A0)
VCC: C44.1, J5.1, U22.20 (VCC)
~CS: J5.3, U22.1 (1OE), U22.19 (2OE)

Notes on the sheet:
Designed to work with: https://github.com/agkaminski/keyboard2
