agkaminski/ZAK180/kicad/memory.kicad_sch

## KiCad design kicad/memory.kicad_sch (2024-08-29)

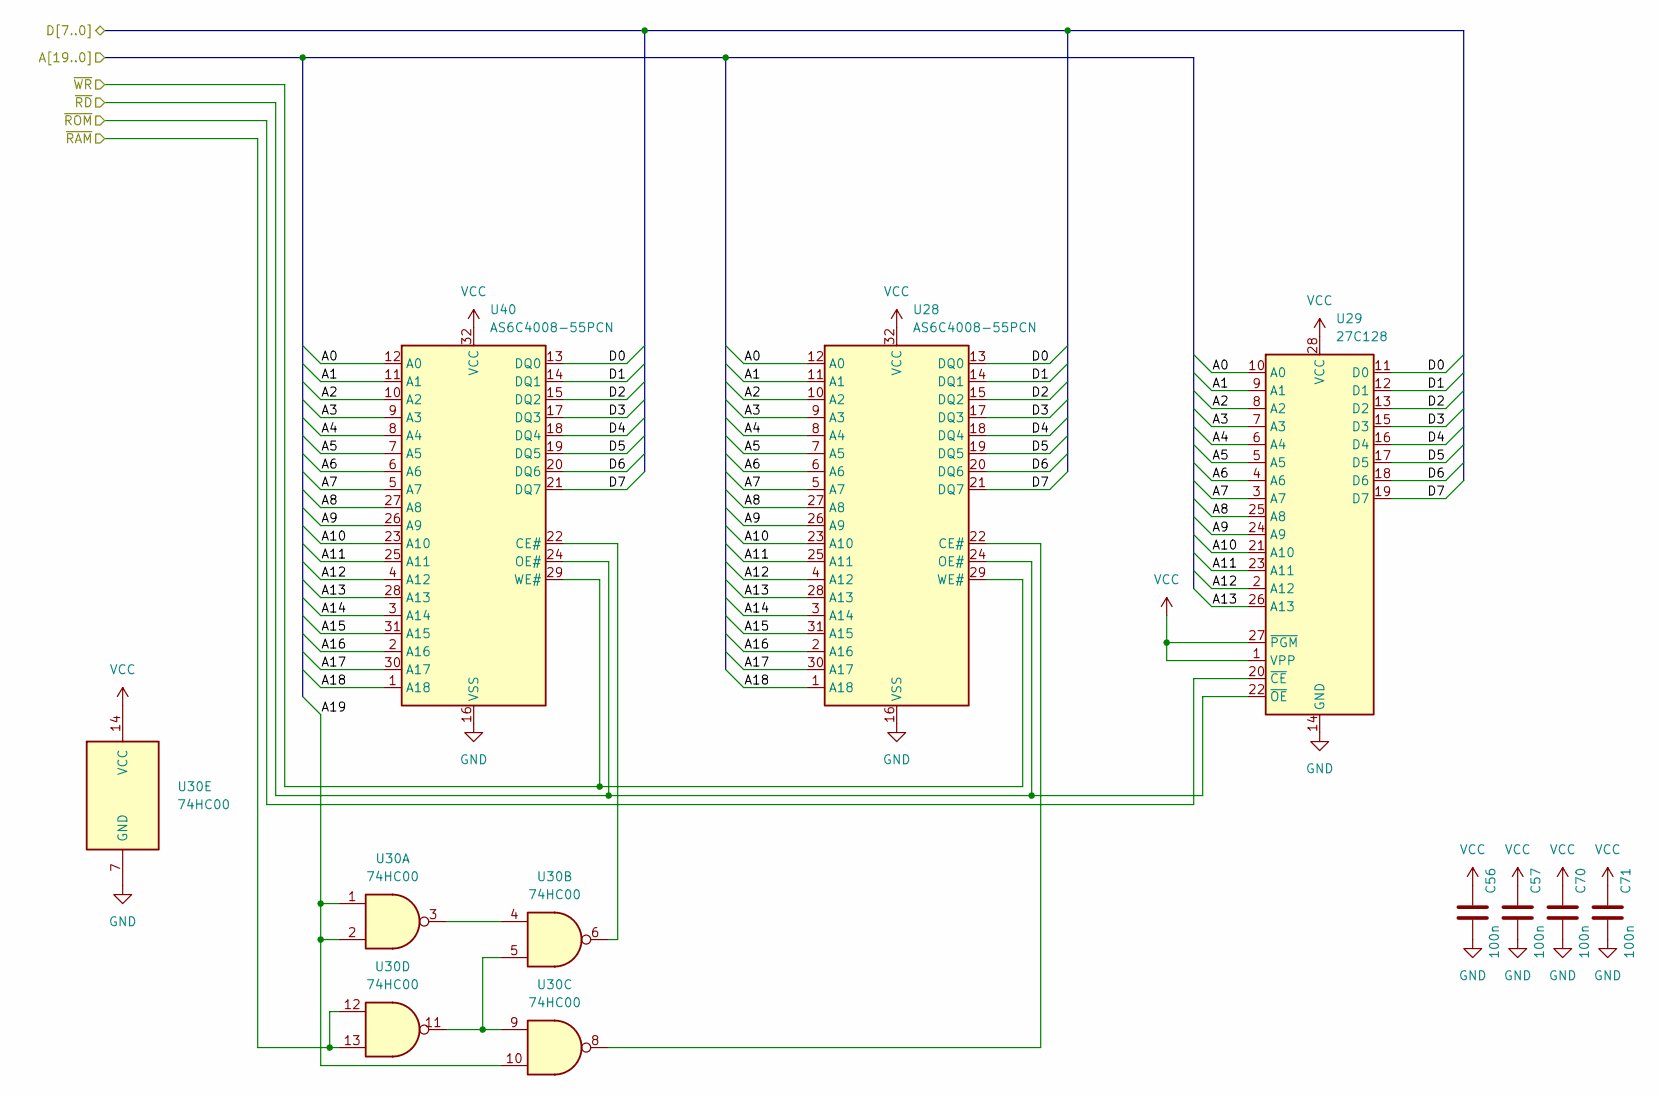
[picture p22: schematic memory.kicad_sch]

Parts:
C56, C57, C70, C71: 100n; C_Disc_D5.0mm_W2.5mm_P2.50mm
U28, U40: AS6C4008-55PCN; DIP-32_W15.24mm
U29: 27C128; DIP-28_W15.24mm
U30: 74HC00; DIP-14_W7.62mm

Connections:
A0: U28.12 (A0), U29.10 (A0), U40.12 (A0)
A1: U28.11 (A1), U29.9 (A1), U40.11 (A1)
A2: U28.10 (A2), U29.8 (A2), U40.10 (A2)
A3: U28.9 (A3), U29.7 (A3), U40.9 (A3)
A4: U28.8 (A4), U29.6 (A4), U40.8 (A4)
A5: U28.7 (A5), U29.5 (A5), U40.7 (A5)
A6: U28.6 (A6), U29.4 (A6), U40.6 (A6)
A7: U28.5 (A7), U29.3 (A7), U40.5 (A7)
A8: U28.27 (A8), U29.25 (A8), U40.27 (A8)
A9: U28.26 (A9), U29.24 (A9), U40.26 (A9)
A10: U28.23 (A10), U29.21 (A10), U40.23 (A10)
A11: U28.25 (A11), U29.23 (A11), U40.25 (A11)
A12: U28.4 (A12), U29.2 (A12), U40.4 (A12)
A13: U28.28 (A13), U29.26 (A13), U40.28 (A13)
A14: U28.3 (A14), U40.3 (A14)
A15: U28.31 (A15), U40.31 (A15)
A16: U28.2 (A16), U40.2 (A16)
A17: U28.30 (A17), U40.30 (A17)
A18: U28.1 (A18), U40.1 (A18)
A19: U30.1, U30.2, U30.10
D0: U28.13 (DQ0), U29.11 (D0), U40.13 (DQ0)
D1: U28.14 (DQ1), U29.12 (D1), U40.14 (DQ1)
D2: U28.15 (DQ2), U29.13 (D2), U40.15 (DQ2)
D3: U28.17 (DQ3), U29.15 (D3), U40.17 (DQ3)
D4: U28.18 (DQ4), U29.16 (D4), U40.18 (DQ4)
D5: U28.19 (DQ5), U29.17 (D5), U40.19 (DQ5)
D6: U28.20 (DQ6), U29.18 (D6), U40.20 (DQ6)
D7: U28.21 (DQ7), U29.19 (D7), U40.21 (DQ7)
GND: C56.2, C57.2, C70.2, C71.2, U28.16 (VSS), U29.14 (GND), U30.7 (GND), U40.16 (VSS)
unnamed: U28.22 (CE#), U30.8
unnamed: U30.3, U30.4
unnamed: U30.6, U40.22 (CE#)
unnamed: U30.5, U30.9, U30.11
VCC: C56.1, C57.1, C70.1, C71.1, U28.32 (VCC), U29.1 (VPP), U29.27 (~PGM), U29.28 (VCC), U30.14 (VCC), U40.32 (VCC)
~RAM: U30.12, U30.13
~RD: U28.24 (OE#), U29.22 (~OE), U40.24 (OE#)
~ROM: U29.20 (~CE)
~WR: U28.29 (WE#), U40.29 (WE#)
