agkaminski/ZAK180/kicad/pio.kicad_sch

## KiCad design kicad/pio.kicad_sch (2024-09-08)

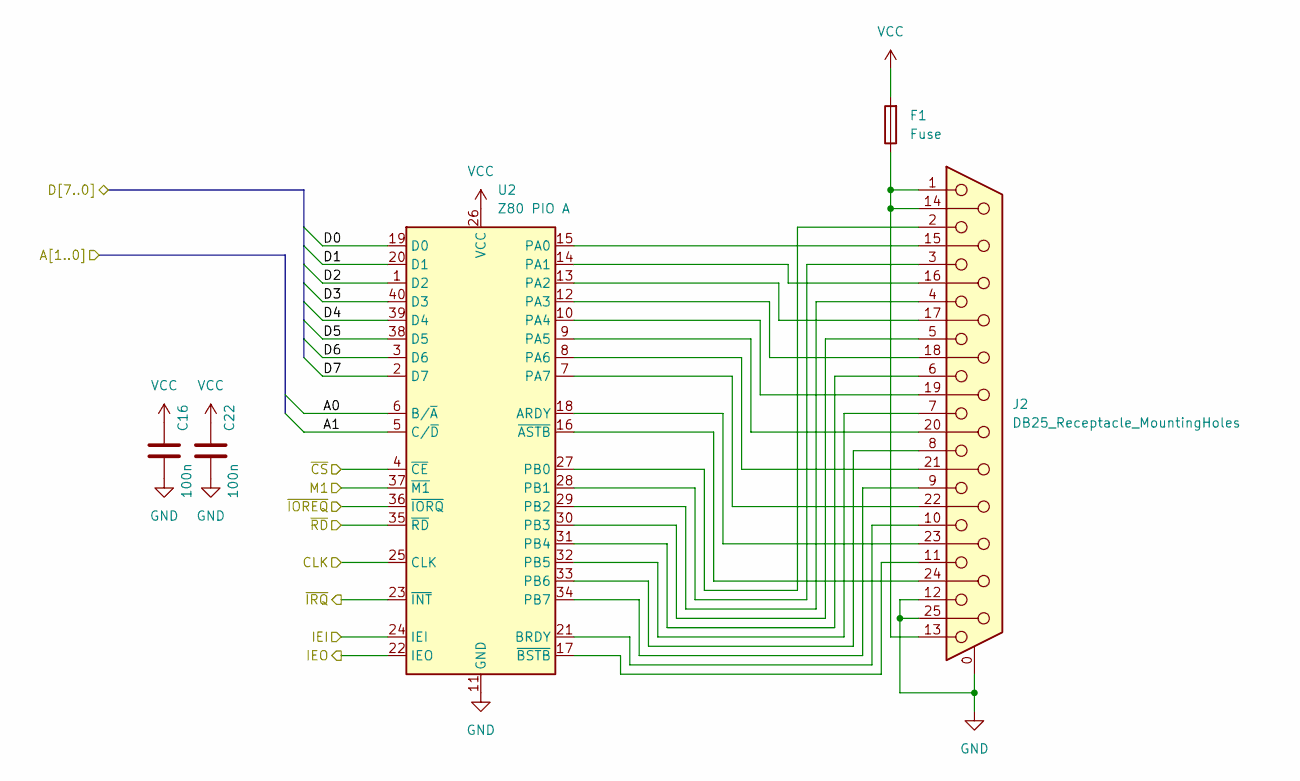
[picture p23: schematic pio.kicad_sch]

Parts:
C16, C22: 100n; C_Disc_D5.0mm_W2.5mm_P2.50mm
F1: Fuse; Fuse_Littelfuse_395Series
J2: DB25_Receptacle_MountingHoles; DSUB-25_Female_Horizontal_P2.77x2.84mm_EdgePinOffset9.90mm_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
U2: Z80 PIO A; DIP-40_W15.24mm

Connections:
A0: U2.6 (B/~A)
A1: U2.5 (C/~D)
CLK: U2.25 (CLK)
D0: U2.19 (D0)
D1: U2.20 (D1)
D2: U2.1 (D2)
D3: U2.40 (D3)
D4: U2.39 (D4)
D5: U2.38 (D5)
D6: U2.3 (D6)
D7: U2.2 (D7)
GND: C16.2, C22.2, J2.0 (PAD), J2.12, J2.25, U2.11 (GND)
IEI: U2.24 (IEI)
IEO: U2.22 (IEO)
M1: U2.37 (~M1)
unnamed: F1.1, J2.1, J2.13, J2.14
unnamed: J2.2, U2.27 (PB0)
unnamed: J2.3, U2.28 (PB1)
unnamed: J2.4, U2.29 (PB2)
unnamed: J2.5, U2.30 (PB3)
unnamed: J2.6, U2.31 (PB4)
unnamed: J2.7, U2.32 (PB5)
unnamed: J2.8, U2.33 (PB6)
unnamed: J2.9, U2.34 (PB7)
unnamed: J2.10, U2.21 (BRDY)
unnamed: J2.11, U2.17 (~BSTB)
unnamed: J2.15, U2.15 (PA0)
unnamed: J2.16, U2.14 (PA1)
unnamed: J2.17, U2.13 (PA2)
unnamed: J2.18, U2.12 (PA3)
unnamed: J2.19, U2.10 (PA4)
unnamed: J2.20, U2.9 (PA5)
unnamed: J2.21, U2.8 (PA6)
unnamed: J2.22, U2.7 (PA7)
unnamed: J2.23, U2.18 (ARDY)
unnamed: J2.24, U2.16 (~ASTB)
VCC: C16.1, C22.1, F1.2, U2.26 (VCC)
~CS: U2.4 (~CE)
~IOREQ: U2.36 (~IORQ)
~IRQ: U2.23 (~INT)
~RD: U2.35 (~RD)
