agkaminski/ZAK180/kicad/serial.kicad_sch

## KiCad design kicad/serial.kicad_sch (2024-09-22)

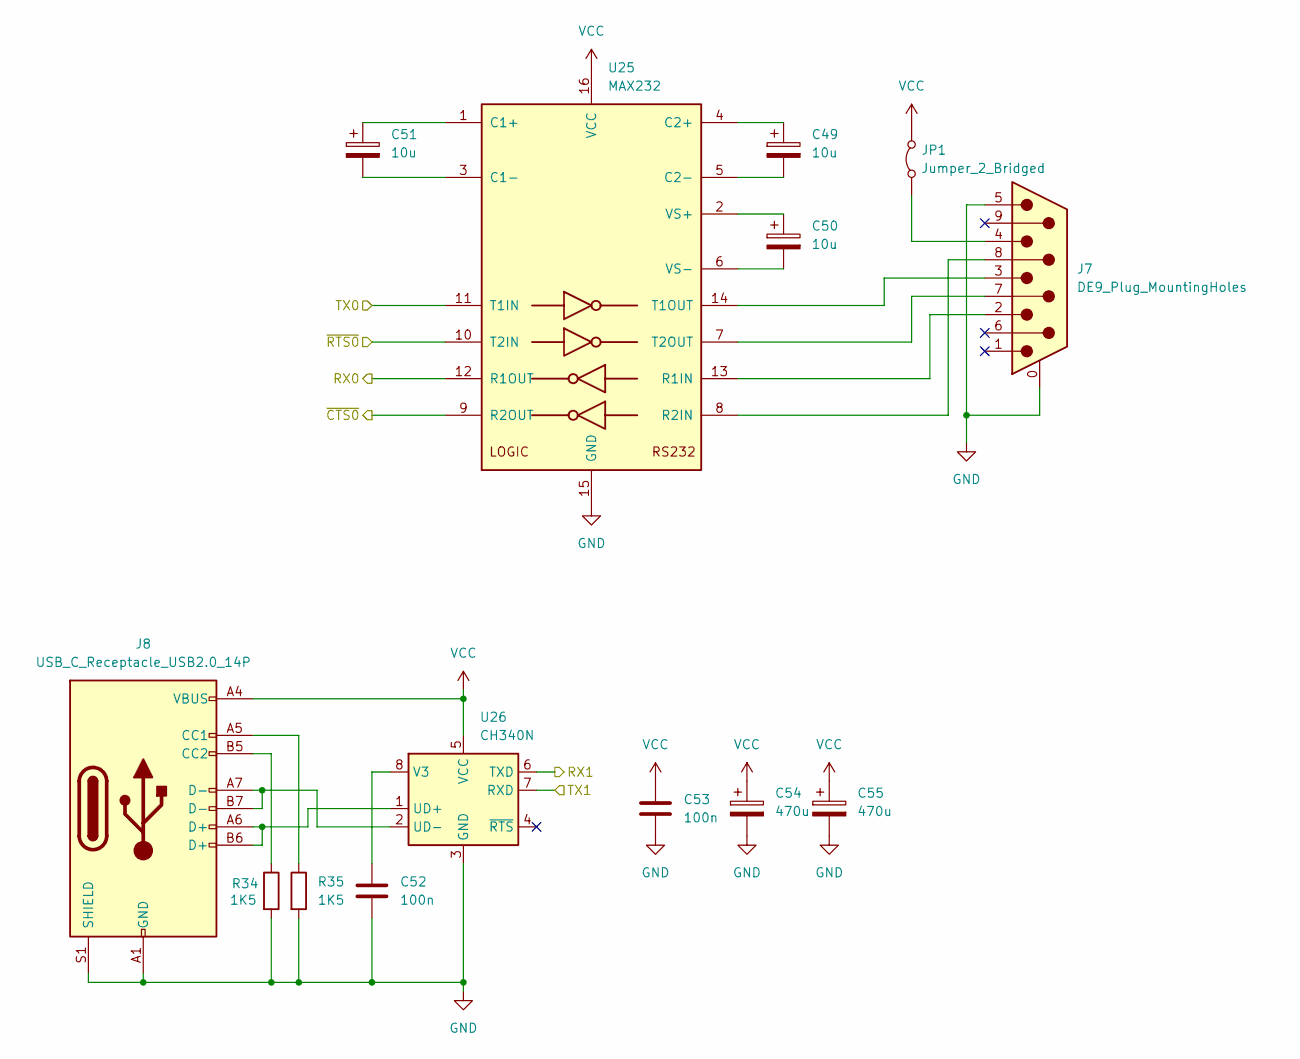
[picture p24: schematic serial.kicad_sch]

Parts:
C49, C50, C51: 10u; CP_Radial_D5.0mm_P2.50mm
C52, C53: 100n; C_Disc_D5.0mm_W2.5mm_P2.50mm
C54, C55: 470u; CP_Radial_D10.0mm_P5.00mm
J7: DE9_Plug_MountingHoles; DSUB-9_Male_Horizontal_P2.77x2.84mm_EdgePinOffset7.70mm_Hou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
J8: USB_C_Receptacle_USB2.0_14P; USB_C_Receptacle_G-Switch_GT-USB-7010ASV
JP1: Jumper_2_Bridged; SolderJumper-2_P1.3mm_Bridged_Pad1.0x1.5mm
R34, R35: 1K5; R_Axial_DIN0207_L6.3mm_D2.5mm_P7.62mm_Horizontal
U25: MAX232; DIP-16_W7.62mm
U26: CH340N; SOP-8_3.9x4.9mm_P1.27mm

Connections:
GND: C52.2, C53.2, C54.2, C55.2, J7.0 (PAD), J7.5, J8.A1 (GND), J8.A12 (GND), J8.B1 (GND), J8.B12 (GND), J8.S1 (SHIELD), R34.2, R35.2, U25.15 (GND), U26.3 (GND)
unnamed: C49.1, U25.4 (C2+)
unnamed: C49.2, U25.5 (C2-)
unnamed: C50.1, U25.2 (VS+)
unnamed: C50.2, U25.6 (VS-)
unnamed: C51.1, U25.1 (C1+)
unnamed: C51.2, U25.3 (C1-)
unnamed: C52.1, U26.8 (V3)
unnamed: J7.2, U25.13 (R1IN)
unnamed: J7.3, U25.14 (T1OUT)
unnamed: J7.4, JP1.1 (A)
unnamed: J7.7, U25.7 (T2OUT)
unnamed: J7.8, U25.8 (R2IN)
unnamed: J8.A5 (CC1), R35.1
unnamed: J8.A6 (D+), J8.B6 (D+), U26.1 (UD+)
unnamed: J8.A7 (D-), J8.B7 (D-), U26.2 (UD-)
unnamed: J8.B5 (CC2), R34.1
RX0: U25.12 (R1OUT)
RX1: U26.6 (TXD)
TX0: U25.11 (T1IN)
TX1: U26.7 (RXD)
VCC: C53.1, C54.1, C55.1, J8.A4 (VBUS), J8.A9 (VBUS), J8.B4 (VBUS), J8.B9 (VBUS), JP1.2 (B), U25.16 (VCC), U26.5 (VCC)
~CTS0: U25.9 (R2OUT)
~RTS0: U25.10 (T2IN)
