agkaminski/ZAK180/kicad/sound.kicad_sch

## KiCad design kicad/sound.kicad_sch (2024-09-10)

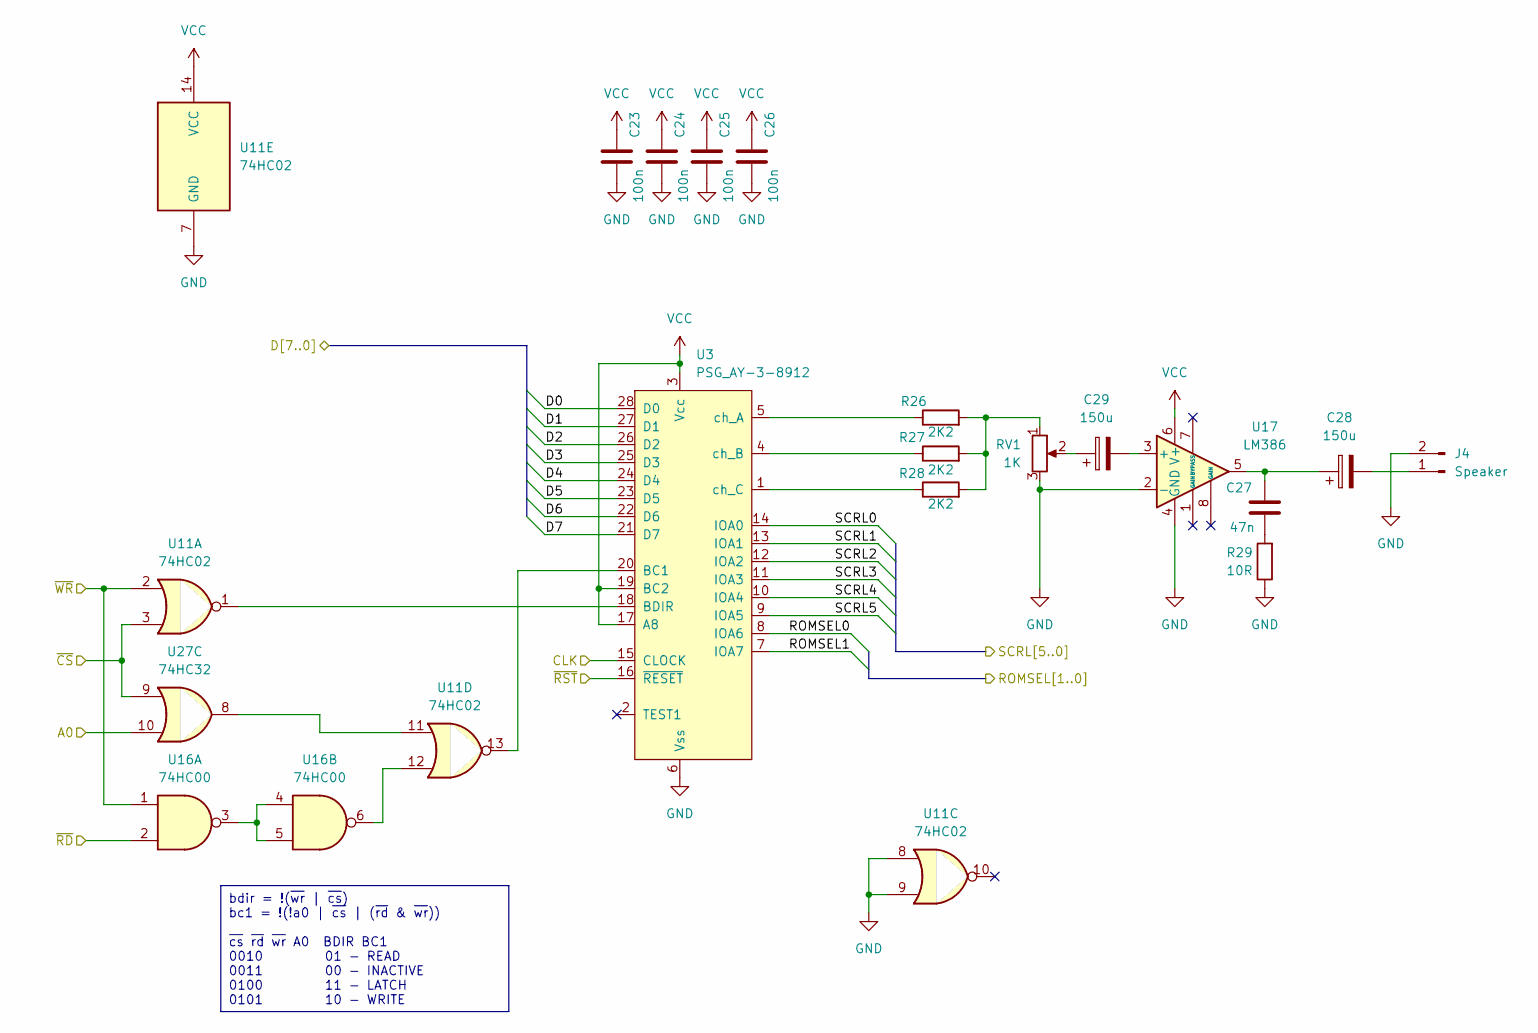
[picture p25: schematic sound.kicad_sch]

Parts:
C23, C24, C25, C26: 100n; C_Disc_D5.0mm_W2.5mm_P2.50mm
C27: 47n; C_Disc_D5.0mm_W2.5mm_P2.50mm
C28, C29: 150u; CP_Radial_D6.3mm_P2.50mm
J4: Speaker; PinHeader_1x02_P2.54mm_Horizontal
R26, R27, R28: 2K2; R_Axial_DIN0207_L6.3mm_D2.5mm_P7.62mm_Horizontal
R29: 10R; R_Axial_DIN0207_L6.3mm_D2.5mm_P7.62mm_Horizontal
RV1: 1K; Potentiometer_Vishay_T73YP_Vertical
U3: PSG_AY-3-8912; DIP-28_W15.24mm
U11: 74HC02; DIP-14_W7.62mm
U16: 74HC00; DIP-14_W7.62mm
U17: LM386; DIP-8_W7.62mm
U27: 74HC32; DIP-14_W7.62mm

Connections:
A0: U27.10
CLK: U3.15 (CLOCK)
D0: U3.28 (D0)
D1: U3.27 (D1)
D2: U3.26 (D2)
D3: U3.25 (D3)
D4: U3.24 (D4)
D5: U3.23 (D5)
D6: U3.22 (D6)
D7: U3.21 (D7)
GND: C23.2, C24.2, C25.2, C26.2, J4.2, R29.1, RV1.3, U3.6 (Vss), U11.7 (GND), U11.8, U11.9, U17.2 (-), U17.4 (GND)
unnamed: C27.1, C28.1, U17.5
unnamed: C27.2, R29.2
unnamed: C28.2, J4.1
unnamed: C29.1, RV1.2
unnamed: C29.2, U17.3 (+)
unnamed: R26.1, U3.5 (ch_A)
unnamed: R26.2, R27.2, R28.2, RV1.1
unnamed: R27.1, U3.4 (ch_B)
unnamed: R28.1, U3.1 (ch_C)
unnamed: U3.18 (BDIR), U11.1
unnamed: U11.11, U27.8
unnamed: U11.12, U16.6
unnamed: U3.20 (BC1), U11.13
unnamed: U16.3, U16.4, U16.5
ROMSEL0: U3.8 (IOA6)
ROMSEL1: U3.7 (IOA7)
SCRL0: U3.14 (IOA0)
SCRL1: U3.13 (IOA1)
SCRL2: U3.12 (IOA2)
SCRL3: U3.11 (IOA3)
SCRL4: U3.10 (IOA4)
SCRL5: U3.9 (IOA5)
VCC: C23.1, C24.1, C25.1, C26.1, U3.3 (Vcc), U3.17 (A8), U3.19 (BC2), U11.14 (VCC), U17.6 (V+)
~CS: U11.3, U27.9
~RD: U16.2
~RST: U3.16 (~RESET)
~WR: U11.2, U16.1

Notes on the sheet:
bdir = !(~{wr} | ~{cs}) bc1 = !(!a0 | ~{cs} | (~{rd} & ~{wr})) ~{cs} ~{rd} ~{wr} A0 BDIR BC1 0010 01 - READ 0011 00 - INACTIVE 0100 11 - LATCH 0101 10 - WRITE
