agkaminski/ZAK180/kicad/vga.kicad_sch

## KiCad design kicad/vga.kicad_sch (2024-08-29)

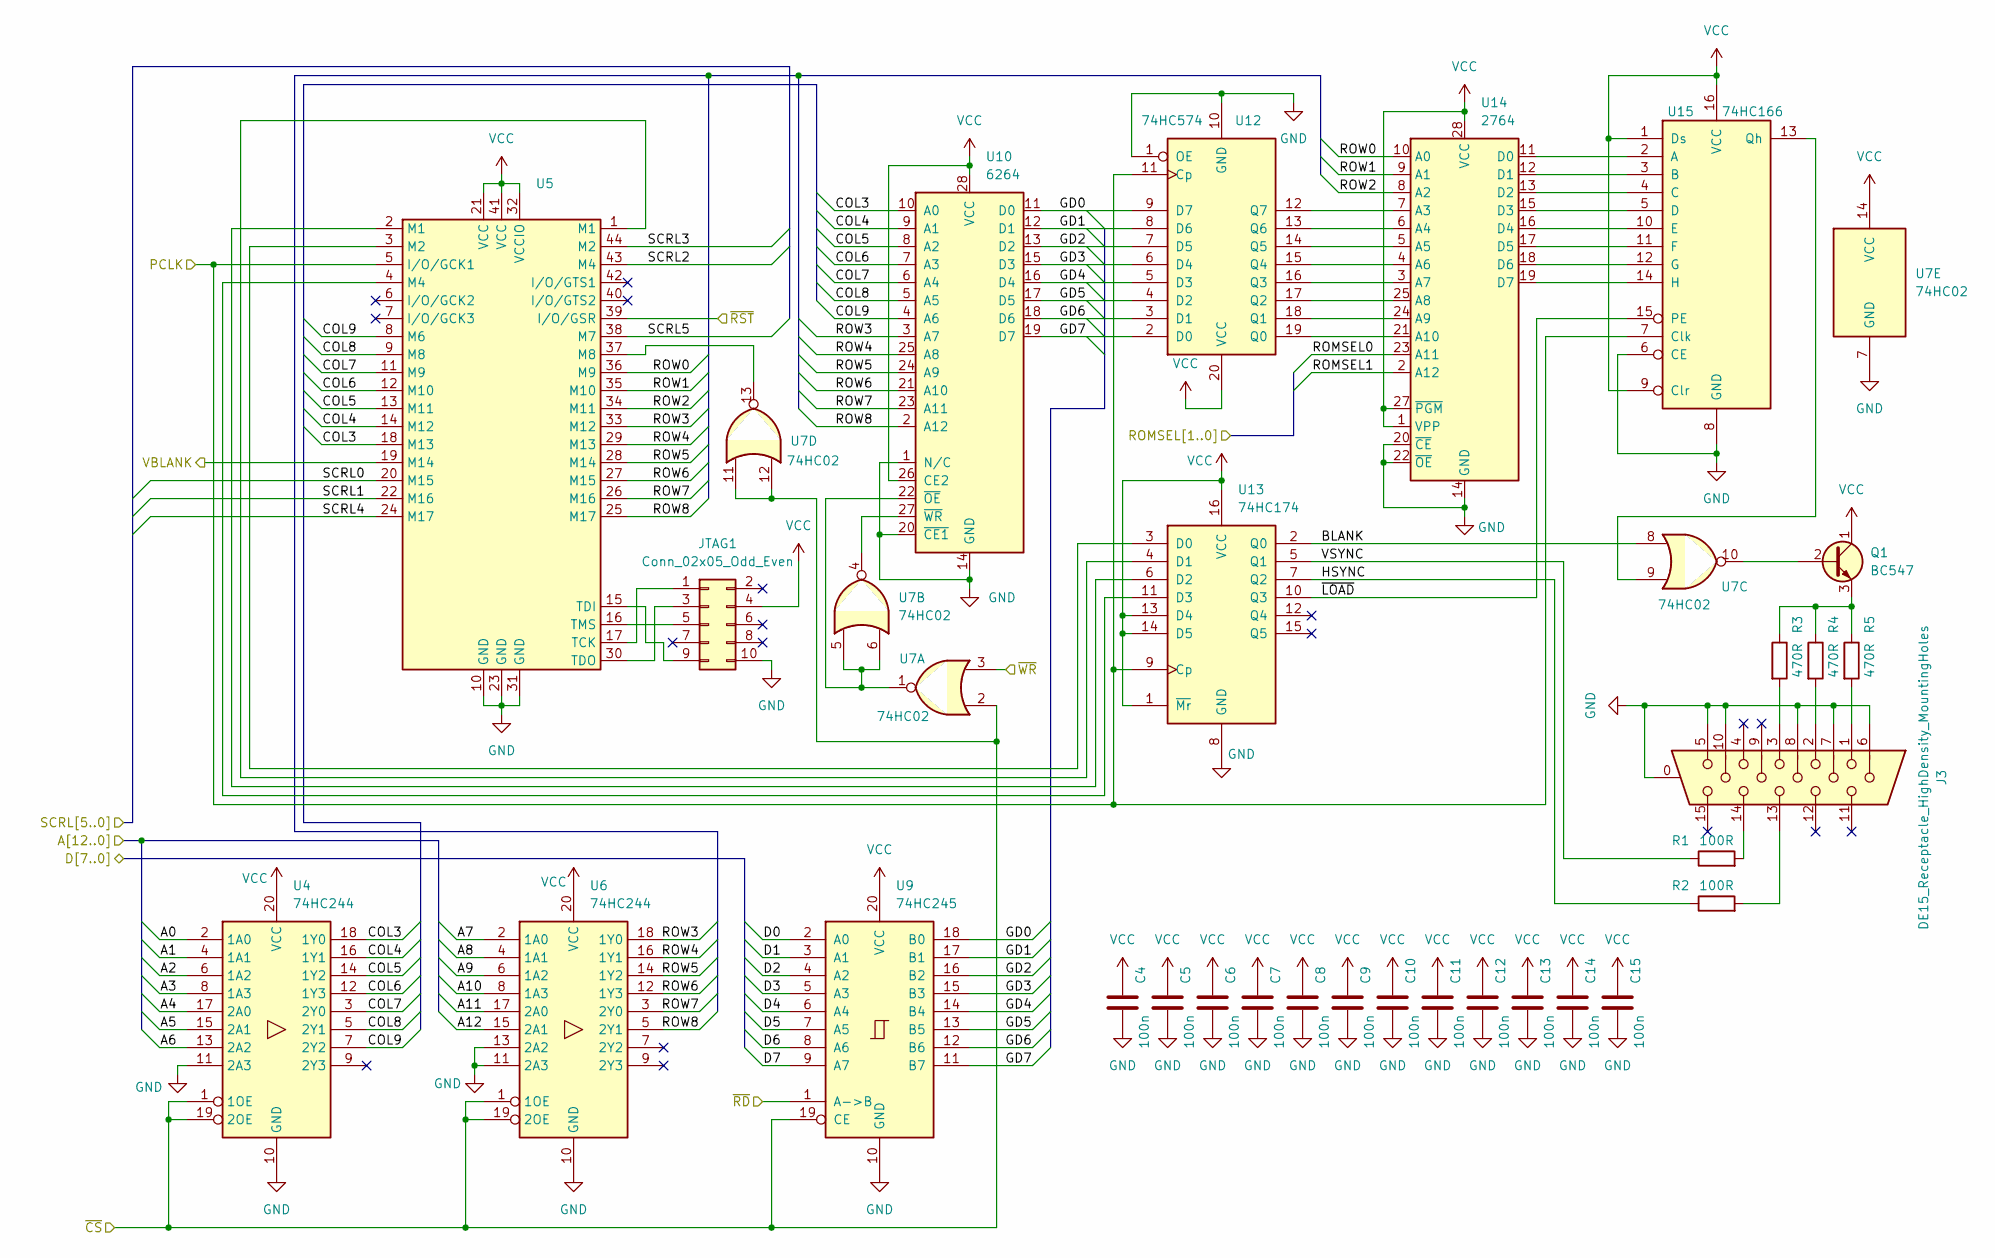
[picture p26: schematic vga.kicad_sch]

Parts:
C4, C5, C6, C7, C8, C9, C10, C11, C12, C13, C14, C15: 100n; C_Disc_D5.0mm_W2.5mm_P2.50mm
J3: DE15_Receptacle_HighDensity_MountingHoles; DSUB-15-HD_Female_Horizontal_P2.29x1.98mm_EdgePinOffset3.03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
JTAG1: Conn_02x05_Odd_Even; IDC-Header_2x05_P2.54mm_Vertical
Q1: BC547; TO-92
R1, R2: 100R; R_Axial_DIN0207_L6.3mm_D2.5mm_P7.62mm_Horizontal
R3, R4, R5: 470R; R_Axial_DIN0207_L6.3mm_D2.5mm_P7.62mm_Horizontal
U4, U6: 74HC244; DIP-20_W7.62mm
U5: XC9536PC44; PLCC-44_THT-Socket
U7: 74HC02; DIP-14_W7.62mm
U9: 74HC245; DIP-20_W7.62mm
U10: 6264; DIP-28_W15.24mm
U12: 74HC574; DIP-20_W7.62mm
U13: 74HC174; DIP-16_W7.62mm
U14: 2764; DIP-28_W15.24mm
U15: 74HC166; DIP-16_W7.62mm

Connections:
A0: U4.2 (1A0)
A1: U4.4 (1A1)
A2: U4.6 (1A2)
A3: U4.8 (1A3)
A4: U4.17 (2A0)
A5: U4.15 (2A1)
A6: U4.13 (2A2)
A7: U6.2 (1A0)
A8: U6.4 (1A1)
A9: U6.6 (1A2)
A10: U6.8 (1A3)
A11: U6.17 (2A0)
A12: U6.15 (2A1)
BLANK: U7.8, U13.2 (Q0)
COL3: U4.18 (1Y0), U5.18 (M13), U10.10 (A0)
COL4: U4.16 (1Y1), U5.14 (M12), U10.9 (A1)
COL5: U4.14 (1Y2), U5.13 (M11), U10.8 (A2)
COL6: U4.12 (1Y3), U5.12 (M10), U10.7 (A3)
COL7: U4.3 (2Y0), U5.11 (M9), U10.6 (A4)
COL8: U4.5 (2Y1), U5.9 (M8), U10.5 (A5)
COL9: U4.7 (2Y2), U5.8 (M6), U10.4 (A6)
D0: U9.2 (A0)
D1: U9.3 (A1)
D2: U9.4 (A2)
D3: U9.5 (A3)
D4: U9.6 (A4)
D5: U9.7 (A5)
D6: U9.8 (A6)
D7: U9.9 (A7)
GD0: U9.18 (B0), U10.11 (D0), U12.9 (D7)
GD1: U9.17 (B1), U10.12 (D1), U12.8 (D6)
GD2: U9.16 (B2), U10.13 (D2), U12.7 (D5)
GD3: U9.15 (B3), U10.15 (D3), U12.6 (D4)
GD4: U9.14 (B4), U10.16 (D4), U12.5 (D3)
GD5: U9.13 (B5), U10.17 (D5), U12.4 (D2)
GD6: U9.12 (B6), U10.18 (D6), U12.3 (D1)
GD7: U9.11 (B7), U10.19 (D7), U12.2 (D0)
GND: C4.2, C5.2, C6.2, C7.2, C8.2, C9.2, C10.2, C11.2, C12.2, C13.2, C14.2, C15.2, J3.0, J3.5, J3.6, J3.7, J3.8, J3.10, JTAG1.10, U4.10 (GND), U4.11 (2A3), U5.10 (GND), U5.23 (GND), U5.31 (GND), U6.10 (GND), U6.11 (2A3), U6.13 (2A2), U7.7 (GND), U9.10 (GND), U10.1 (N/C), U10.14 (GND), U10.20 (~CE1), U12.1 (OE), U12.10 (GND), U13.8 (GND), U14.14 (GND), U14.20 (~CE), U14.22 (~OE), U15.6 (CE), U15.8 (GND)
HSYNC: R2.1, U13.7 (Q2)
unnamed: J3.1, R5.2
unnamed: J3.2, R4.2
unnamed: J3.3, R3.2
unnamed: J3.13, R2.2
unnamed: J3.14, R1.2
unnamed: JTAG1.1, U5.17 (TCK)
unnamed: JTAG1.3, U5.30 (TDO)
unnamed: JTAG1.5, U5.16 (TMS)
unnamed: JTAG1.9, U5.15 (TDI)
unnamed: Q1.2 (B), U7.10
unnamed: Q1.3 (E), R3.1, R4.1, R5.1
unnamed: U5.37 (M8), U7.13
unnamed: U7.1, U7.5, U7.6, U10.22 (~OE)
unnamed: U7.4, U10.27 (~WR)
unnamed: U12.12 (Q7), U14.7 (A3)
unnamed: U12.13 (Q6), U14.6 (A4)
unnamed: U12.14 (Q5), U14.5 (A5)
unnamed: U12.15 (Q4), U14.4 (A6)
unnamed: U12.16 (Q3), U14.3 (A7)
unnamed: U12.17 (Q2), U14.25 (A8)
unnamed: U12.18 (Q1), U14.24 (A9)
unnamed: U12.19 (Q0), U14.21 (A10)
unnamed: U5.3 (M2), U13.3 (D0)
unnamed: U5.1 (M1), U13.4 (D1)
unnamed: U5.2 (M1), U13.6 (D2)
unnamed: U5.4 (M4), U13.11 (D3)
unnamed: U14.11 (D0), U15.2 (A)
unnamed: U14.12 (D1), U15.3 (B)
unnamed: U14.13 (D2), U15.4 (C)
unnamed: U14.15 (D3), U15.5 (D)
unnamed: U14.16 (D4), U15.10 (E)
unnamed: U14.17 (D5), U15.11 (F)
unnamed: U14.18 (D6), U15.12 (G)
unnamed: U14.19 (D7), U15.14 (H)
unnamed: U7.9, U15.13 (Qh)
PCLK: U5.5 (I/O/GCK1), U12.11 (Cp), U13.9 (Cp), U15.7 (Clk)
ROMSEL0: U14.23 (A11)
ROMSEL1: U14.2 (A12)
ROW0: U5.36 (M9), U14.10 (A0)
ROW1: U5.35 (M10), U14.9 (A1)
ROW2: U5.34 (M11), U14.8 (A2)
ROW3: U5.33 (M12), U6.18 (1Y0), U10.3 (A7)
ROW4: U5.29 (M13), U6.16 (1Y1), U10.25 (A8)
ROW5: U5.28 (M14), U6.14 (1Y2), U10.24 (A9)
ROW6: U5.27 (M15), U6.12 (1Y3), U10.21 (A10)
ROW7: U5.26 (M16), U6.3 (2Y0), U10.23 (A11)
ROW8: U5.25 (M17), U6.5 (2Y1), U10.2 (A12)
SCRL0: U5.20 (M15)
SCRL1: U5.22 (M16)
SCRL2: U5.43 (M4)
SCRL3: U5.44 (M2)
SCRL4: U5.24 (M17)
SCRL5: U5.38 (M7)
VBLANK: U5.19 (M14)
VCC: C4.1, C5.1, C6.1, C7.1, C8.1, C9.1, C10.1, C11.1, C12.1, C13.1, C14.1, C15.1, JTAG1.4, Q1.1 (C), U4.20 (VCC), U5.21 (VCC), U5.32 (VCCIO), U5.41 (VCC), U6.20 (VCC), U7.14 (VCC), U9.20 (VCC), U10.26 (CE2), U10.28 (VCC), U12.20 (VCC), U13.1 (~Mr), U13.13 (D4), U13.14 (D5), U13.16 (VCC), U14.1 (VPP), U14.27 (~PGM), U14.28 (VCC), U15.1 (Ds), U15.9 (Clr), U15.16 (VCC)
VSYNC: R1.1, U13.5 (Q1)
~CS: U4.1 (1OE), U4.19 (2OE), U6.1 (1OE), U6.19 (2OE), U7.2, U7.11, U7.12, U9.19 (CE)
~LOAD: U13.10 (Q3), U15.15 (PE)
~RD: U9.1 (A->B)
~RST: U5.39 (I/O/GSR)
~WR: U7.3
