agkaminski/ZAK180/kicad/zak180.kicad_sch

## KiCad design kicad/zak180.kicad_sch (2024-09-10)

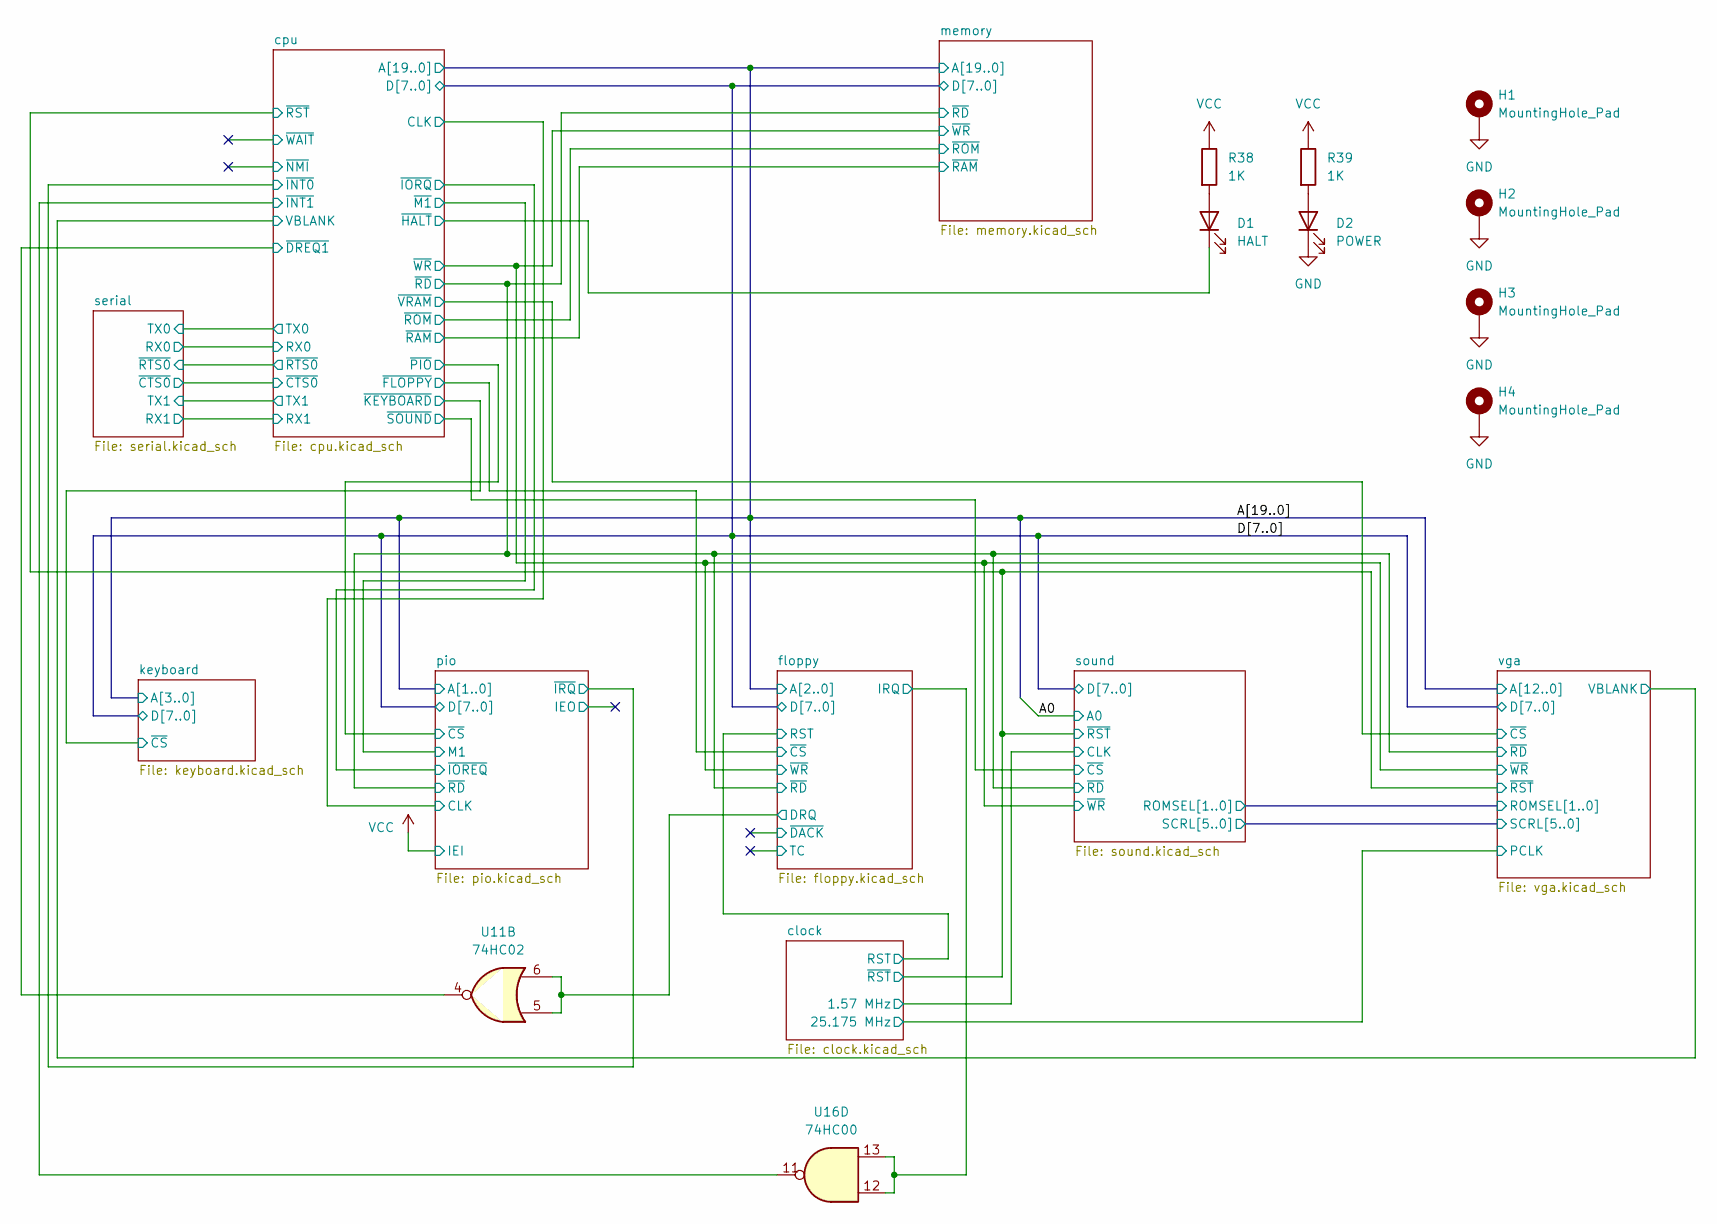
[picture p27: schematic zak180.kicad_sch]

Parts:
D1: HALT; LED_D5.0mm
D2: POWER; LED_D5.0mm
H1, H2, H3, H4: MountingHole_Pad; MountingHole_3.2mm_M3_Pad_Via
R38, R39: 1K; R_Axial_DIN0207_L6.3mm_D2.5mm_P7.62mm_Horizontal
U11: 74HC02; DIP-14_W7.62mm
U16: 74HC00; DIP-14_W7.62mm

Connections:
DRQ: U11.5, U11.6
GND: D2.1 (K), H1.1, H2.1, H3.1, H4.1
IRQ: U16.12, U16.13
unnamed: D1.2 (A), R38.2
unnamed: D2.2 (A), R39.2
VCC: R38.1, R39.1
~DREQ1: U11.4
~HALT: D1.1 (K)
~INT1: U16.11
