agkaminski/ZAK180/(commit log)

2024-08-29 FW: start work on drivers
    [bom.csv, clock.kicad_sch, cpu.kicad_sch, designators.csv, floppy.kicad_sch, keyboard.kicad_sch, memory.kicad_sch, pio.kicad_sch]
2024-08-29 HW: Fix UART1 having RX and TX swapped
    [bom.csv, designators.csv, positions.csv, serial.kicad_sch, zak180.kicad_sch]
2024-08-29 Update README and issues
    [bom.csv, designators.csv, positions.csv]
2024-08-30 HW: Fix bug in I/O decoder
    [cpu.kicad_sch]
2024-08-30 Drivers: Add makefile, fix AY-3-8912
    [ay38912.c, uart.c]
2024-08-30 driver: Start work on floppy controller driver
2024-08-30 schematic: Fix incorrect information about 82077 mode
    [floppy.kicad_sch]
2024-08-31 driver: working floppy sector read
2024-08-31 driver/floppy: slight cleanup
2024-08-31 driver/floppy: improve error handling
    [floppy.c, main.c]
2024-08-31 driver/floppy: refactor
2024-08-31 driver/floppy: Working read and write
2024-08-31 driver/floppy: Rename lower layer, working access to the whole disk
2024-08-31 driver: add PIO driver
2024-08-31 driver/floppy: add floppy interface wrapers
2024-08-31 driver/floppy: remove redundant seek
2024-09-01 driver/floppy: optimize FIFO read/write, add timeout
2024-09-01 driver/floppy: fix buggy retval check
    [floppy.c, main.c]
2024-09-01 driver/floppy: Fix build, use asm local labels
    [floppy_cmd.c]
2024-09-01 driver/floppy: add comment about not working eject detection, change delay
    [floppy_cmd.c, main.c]
2024-09-01 driver/floppy: remove explicit RET
2024-09-01 driver/floppy: Fix write regression
    [floppy.c, floppy_cmd.c]
2024-09-02 floppy: Fix disk change detection
    [floppy.c, floppy_cmd.c]
2024-09-02 HW: remove unnecessary kicad files
2024-09-04 FW: Add interrupts handling in bootloader
2024-09-07 driver: start work on VGA
2024-09-07 vga: mostly working vga driver
2024-09-08 HW: Fix A0 of AY-3-8912 being connected to D0 instead of A0
    [cpu.kicad_sch, pio.kicad_sch, sound.kicad_sch, zak180.kicad_sch]
2024-09-09 FAT12: Fix UB in file_read preventing reads over 512 bytes
    [main.c]
2024-09-09 Update schematic pdf file
2024-09-09 Add devkit STL model
    [dev.FCStd, dev.stl]
2024-09-10 HW: Fix address and data buses being swapped for keyboard connector
    [zak180.kicad_sch]
2024-09-10 HW: update schematic pdf
2024-09-10 HW: Connect 82077 /DREQ to the Z180 DMA ch 1, PCB decorations
    Rev B done
    [bom.csv, cpu.kicad_sch, designators.csv, positions.csv, sound.kicad_sch, zak180.kicad_sch]
2024-09-11 UART: use interrupts
2024-09-14 UART: Fix warning
2024-09-14 kernel: working systick timer
2024-09-15 kernel: start work on threads
2024-09-16 kernel: working thread sleep
2024-09-16 fw: fix header paths
    [main.c]
2024-09-16 kernel/proc: fix incorrect version of timer_get being used
2024-09-16 Replace irq disable with scheduler lock. Make critical section not enabled on boot
    [critical.c, critical.h, floppy_cmd.c, main.c, prt.c]
2024-09-16 VGA: fix wrong version of vga_set being used
    [vga.c]
2024-09-17 VGA: guard against cursor handling in the interrupt
2024-09-22 HW: Fix unconnected /SOUND net, add /RST header and /DTR power supply
    [clock.kicad_sch, cpu.kicad_sch, floppy.kicad_sch, serial.kicad_sch]
2024-09-22 HW: revision C
    [bom.csv, designators.csv, positions.csv]
2024-10-10 HW: remove rev A gerbers
    [bom.csv, designators.csv, positions.csv]
2024-10-10 HW: add ESP32 dongle
    [ESP8266.kicad_pcb, ESP8266.kicad_sch, bom.csv, case.stl, designators.csv, positions.csv]
2024-10-24 driver: compile all drivers to the single lib
2024-10-24 FAT: start work on a'la vfs FAT implementation (WIP)
2024-12-14 kernel: define block device API + floopy blk
2024-12-14 vfs: improve API, mount implementation
2024-12-15 dev: fix floppy blk argument types
    [floppy.c]
2024-12-15 dev: fix floppy pseud-cache thining it has read sector #0
    [floppy.c]
2024-12-15 kernel: mount rootfs
2024-12-16 kernel: fix sleep value (ms, not us)
    [main.c]
2025-01-11 3D: add case 3D model (FreeCAD + STL)
    [bottom.FCStd, bottom.stl, case.FCStd, case.stl]
2025-01-12 3D: improve case model
    [case.FCStd, case.stl]
2025-01-12 3D/case: add vent holes, move PCB to clear IO plugs
    [case.FCStd, case.stl]
2025-01-13 3D: fix bottom no longer matching case, move it to the one FreeCAD file
    [bottom.FCStd, bottom.stl, case.FCStd, case.stl]
2025-01-19 fs: fix mount regression
